lauyihong/lerobotneck/hardware/neck_v0_1/README.md

# neck_v0_1 CAD

| file | source | notes |
|---|---|---|
| `wallerobot_new_wrist_dof_0_1.stl` | user, 2026-11-04 | binary STL, mm, 66170 faces, one solid (+ a few degenerate slivers), exported in **part** coordinates (min corner at origin), not assembly coordinates |

## `wallerobot_new_wrist_dof_0_1.stl` — measured features (part frame, mm)

Extent 52.95 × 46.4 × 48.4. Two functional ends:

- **Socket** (X 0–15): rectangular pocket Y 11.4–36.4 × Z 11.4–46.3 (25.0 × 34.9), ~15 deep, open towards −X.
  The cross-section matches an STS3215 body (24.7 × 35). Ø5.0 through hole on the pocket floor along X at (Y 23.9, Z 28.0).
  Screw holes along Z, Y = 13.63 / 34.13 (20.5 apart): bottom wall at X 9.1 (Ø4 counterbore → Ø2 pilot),
  top wall at X 12.9 (Ø2 pilot → Ø4 counterbore).
- **Fork** (X ≈ 20–53): two arms, inner faces Y ≈ 3.5 and 42.9 (gap ≈ 39.4). Both arm ends carry a horn pattern on one
  axis: **rotation axis ∥ Y through (X 41.0, Z 12.0)**; Ø6.0 centre hole, 4 × Ø3.2 (Ø5.4 counterbore on the outer face)
  on a Ø14.1 bolt circle.

Socket axis (X, through Y 23.9 / Z 28.85) → fork axis: 16.85 mm lower in Z, 26 mm beyond the pocket floor (X 15 → 41).

## Role in the neck (user photo 2026-11-04 + inference — confirm before building the URDF)

- This part is the **new link between J3 and J4**, replacing the SO101 `Lower_Arm` (J3→J4 = 134.9 mm in upstream URDF).
  Fork = on the J3 horn (J3 axis ∥ part Y). Socket = holds the J4 motor body.
- STS3215 in the upstream meshes: 45.4 × 24.8 × 39.6 (shaft ∥ the 39.6 side, shaft 10.2 mm from one end). The pocket
  takes the 24.8 side along Y and the 35 side along Z, so **the J4 shaft is ∥ Z, i.e. perpendicular to J3**
  (in SO101 J3 ∥ J4). **Confirmed by user 2026-11-04: J4 swings the camera sideways.** The downstream SO101 wrist
  (J4→J6) is therefore rotated 90° about the link axis relative to stock SO101.
  If the non-shaft end sits on the pocket floor, the J4 axis passes through (X ≈ −20.2, Y 23.9),
  ≈ 61 mm from the J3 axis along X (position not yet measured on the real part).
- Camera end: D435i holder from upstream XLeRobot on the J6 horn. CAD available in
  `third_party/XLeRobot/hardware/step/RGBD_Gimbal/Gimbal_Pitch_Holder_d435_d415.step` and
  `third_party/XLeRobot/hardware/camera_connector/Gimbal_mesh_all_d435.stl`; upstream URDF puts `head_camera_link`
  at (0.025, 0, 0.03) m from the head tilt axis (rounded values).
- Rest of the chain (J1/J2 base + shoulder, upper arm, wrist, J6 housing) looks like stock SO101 in the photo.

## URDF draft v0.1 — `urdf/wallerobot_neck.urdf`

Generated by `build_urdf.py` (edit the script, then re-run; it also checks the file loads in MuJoCo).
Preview: `render_mj.py --q j1,..,j6 (deg) --out x.png` (MuJoCo, coloured) or `view_urdf.py` (matplotlib) — `guess_q0.png` (zero pose), `guess_j4_AB.png` (J4 horn question, answered B), `compare_photo_fold.png` (user photos vs URDF in an eyeballed folded pose).

```
wallerobot_body (root, upstream top_base_link) --fixed--> neck_base (SO101 Base frame) --neck_j1--> neck_shoulder --neck_j2--> neck_upper_arm --neck_j3--> neck_link34 (our STL)
  --neck_j4--> neck_wrist (SO101 Wrist_Pitch_Roll) --neck_j5--> neck_cam_tilt_housing (SO101 Fixed_Jaw, J6 motor)
  --neck_j6--> neck_cam_holder (XLeRobot head-tilt holder + D435i) -> neck_camera_link -> neck_camera_color_optical_frame
```

Joint names neck_j1..neck_j6 = motor IDs 7..12. Zeros (= what the calibration reference pose must reproduce):
J1, J2 as the SO101 URDF (J2 = 0: upper arm stretched out horizontally); J5 = 0: user's normal state, D435i landscape + upright below the J6 housing (SO101 zero − 90°); J3 = 0: J4 motor in line with the upper arm;
J4 = 0: wrist straight along the J4 motor; J6 = 0: camera optical axis along the J5 roll axis, looking away from the wrist.
At q = 0 the neck is stretched out horizontally and the camera looks straight forward (`preview_q0.png`).

| item | status |
|---|---|
| J1–J3, wrist J4→J6 frames | upstream SO101 (`third_party/XLeRobot/simulation/xlerobot/xlerobot.urdf`, left arm) |
| J3→J4 (new link) | from the STL: J3→J4 axis offset 61.2 mm along the link + 16.85 mm sideways |
| `LINK34_SIDE = -1` | inferred from the photo (J4 motor on the far side from the upper arm when folded; `preview_link_side_check.png`) |
| `J4_SHAFT_SIGN = -1` | user 2026-11-04: real neck stretched out looks like variant **B** in `guess_j4_AB.png` |
| `HOLDER_FLIP = -1` | user: holder is mirrored vs the old head ("pink is reversed"); photo only fits -1 (camera body below-forward of the J6 horn) |
| J4 motor insertion depth | **ASSUMPTION** — non-shaft end on the pocket floor; measure J3↔J4 axis distance with calipers to confirm |
| camera in holder | upstream head values (`head_camera_link` 25 mm fwd / 30 mm up of the tilt axis, rounded); colour vs depth optical offset not modelled yet (SDK extrinsics) |
| joint limits | from `neck_calibration.json` (calibrated 2026-11-05, see Calibration below) |
| J6 housing | user 2026-11-04: real part = XLeRobot TPU-finger fixed jaw with the finger removed -> `cam_tilt_housing_softfin.stl` (largest body of `third_party/XLeRobot/hardware/SO101_soft_fin.stl`), ICP-placed in the SO101 Fixed_Jaw frame (0.39 mm median) |
| neck base / mount | user 2026-11-04: SO101 Base replaced by the XLeRobot neck part. Root = `wallerobot_body` (= upstream `top_base_link`, topbase1/2 meshes); J1 motor ICP-matched onto the old head-pan motor (0.44 mm), J1 axis at x -104 mm (upstream pan axis -103). Robot forward = body -X (left arm at -Y shows on the image left). Real body vs upstream CAD not measured |
| J5 zero / camera upright | user 2026-11-04 picked **C** in `guess_j5_ABCD.png` as the normal state: `J5_ZERO_SHIFT = -90 deg` (vs SO101 zero), holder + camera below the J6 housing (matches the folded photo). User says the camera is upright there, so `CAM_FLIP`: D435i rotated 180 deg about its optical axis in the holder vs upstream (unverified with a live frame; colour lens lateral offset not modelled) |
| inertias | placeholders (0.05 kg links) so simulators accept the file |
| base visuals | user 2026-11-05 picked **candidate 4** in `guess_base_candidates.png` = upstream `hardware/step/Archiv/Neck.step`: truss tower + separate J1 housing ("Folder 136", 65×65×60 mm). Same frame as `Assembly_RGBD_Gimbal.step` (identical tower bounds) → body frame by a pure translation (0.65 mm ICP). `make_base_meshes.py` writes `base_body_lower.stl` (upstream topbase1 cut below the tower at z 106.5 mm), `base_tower.stl`, `base_j1_housing.stl`; topbase2 kept as the J1 motor. The housing encloses the J1 motor where it already was (J1 axis x −104 mm) → **J1 position and zero unchanged**, calibration still valid. Check: `compare_base4.png` (home pose vs photos), `guess_q0.png` |

## Calibration — `tools/calib_neck.py`

Hand-guided, torque never enabled. `guide` renders `calib_guide.png` (zero pose + the `+30°` direction of every joint),
`calibrate` records per joint: zero (homing so it reads 2047), sign (you turn it the way the guide shows), range
(unwrapped, so J5 may cross the encoder wrap; > 1 rev is clipped symmetrically) → EEPROM offset re-centred on the range
midpoint + limits minus a 40-tick margin, and `neck_calibration.json` (`q = sign·(Present_Position − zero_tick)·2π/4096`).
Old EEPROM values are backed up to `calib_backups/` and restored on any failure or Ctrl+C. `build_urdf.py` takes the
joint limits from `neck_calibration.json` when it exists. `show` reads the encoders and renders `live_pose.png`.
Tested offline against a simulated bus (wrap, reversed signs, J5 > 1 rev, bad reads).
The input-voltage status error on IDs 9/10/11 that blocked LeRobot was cleared 2026-11-04 (Max_Voltage_Limit 12.0 → 14.0 V,
see `hardware.yaml` → `eeprom_20261104_evening.fix_20261104`).

**Calibrated on the robot 2026-11-05 00:4x** (3rd attempt; backup `calib_backups/eeprom_20261105-000939.json`), read-back ±1 tick:

| joint | ID | homing | range (ticks) | zero tick | sign | URDF limits (°) |
|---|---|---|---|---|---|---|
| neck_j1 | 7 | −1861 | 910..3185 | 1920 | +1 | −89 .. +111 |
| neck_j2 | 8 | −1224 | 895..3200 | ~~2942~~ **3022** (IMU demo fit) | −1 | −16 .. +187 |
| neck_j3 | 9 | +1505 | 1095..3000 | ~~1108~~ **948** (fixed, see below) | +1 | ~~−1 .. +166~~ **+13 .. +180** |
| neck_j4 | 10 | +1545 | 863..3232 | ~~2076~~ **2037** (IMU fit) | −1 | −105 .. +103 |
| neck_j5 | 11 | +118 | 182..3913 | 992 | −1 | −257 .. +71 |
| neck_j6 | 12 | −838 | 1203..2891 | 2120 → 2219 → **2115** (IMU demo fit) | +1 | −80 .. +68 |

URDF rebuilt with these limits. Notes: the drooping rest pose puts J2 at −26° = 41 ticks past range_max (the 40-tick margin)
→ with torque on, the motor would clamp the goal to the limit (≈4° move). J1 sign differed between the aborted 1st run (−)
and runs 2/3 (+). **User 2026-11-05: `live_pose.png` (q = −5, −26, +45, −0, −5, +23°) matches the real neck** → signs
and zeros accepted.

**Poses** (`tools/calib_neck.py save-pose <name>`, stored under `poses` in `neck_calibration.json`):
`home` (2026-11-05, user: use as init / return position) = folded rest, camera forward,
q = −5.3, +187.2, +185.0 (was +171.0 before the J3 zero fix), +1.2 (was +4.7), −1.2, −1.1 (was +7.6, IMU fit)°. J2/J3 rest on the mechanical stop beyond
the calibrated limits → use `target_ticks` / `target_q_deg` (J2 +179.9°, J3 +180.3°, clamped to the limits) as the goal,
never push further into the stop.

**J3 zero fix (2026-11-05)**: in the folded home pose the real wrist touches the upper arm, but with zero_tick 1108 the model
(J3 +171°) showed a 13.8 mm gap. User: the real neck looks like the model at ~+184.5° → the eyeballed J3 zero ("J4 motor in
line with the upper arm") was ~13° off; fix it from the contact. Model contact (signed-distance sweep, wrist vs upper arm at the
home pose) = J3 **+185.1°**; real fold stop = tick **3054** (`watch_neck_j3.json` max, home 3053–3055) → `zero_tick` 1108 → **948**
(file only, EEPROM untouched; backup `calib_backups/neck_calibration_20261105-before_j3_zero_fix.json`). Home now reads J3 +185.0°,
model gap ≈ 0 (`compare_elbow_home.png`). Open point: J3 stretched to its stop by hand read −4.3° old = **+9.8° new**, while the
model's extension contact is ≈ −5..−8° → the real extension stop is something not in the model (not pushed hard; cable / horn?)
— harmless, the URDF lower limit is +13°.
| neck_base → robot body / arm bases | from upstream CAD (see neck base row); upstream arm bases Base/Base_2 at (-0.09, ∓0.11, 0.395) in chassis = (-0.09, ∓0.11, 0.045) in top_base_link |

**Archive**: `archive/neck_v0_1_20261105.zip` (+ `MANIFEST_20261105.md`) = snapshot of this folder after the J3 zero fix (URDF + meshes, calibration, backups, photos, scripts). Helpers: `check_fold_contact.py` (J3 fold contact sweep), `compare_elbow.py` (photo vs model elbow).

**IMU zero fix J4/J6 (2026-11-05)**: D435i gravity vs the twin (`projects/sim_mirror/scripts/imu_fit.py`) over 3 static poses
(2 hand-posed + the home `imu_check`) said the camera pitch was 8.7° off. With J2 held at its rest-stop anchor and the camera roll in
the holder fixed at 0 (fit: +0.7 ± 0.5°, not significant): **J6 −8.68 ± 0.45°** → `zero_tick` 2120 → **2219**, **J4 −3.43 ± 0.57°** →
2076 → **2037** (file only, EEPROM untouched; backup `calib_backups/neck_calibration_20261105-before_imu_fix.json`). rms 9.1° → 0.9°;
an independent 4th pose (J4 +18, J6 −52, roll −21°) afterwards: 0.9° between real and sim gravity. **Provisional**: J4/J5 were small in
every pose, so the J2 and J6 axes were parallel and only δJ2 − δJ6 is measured (4-pose fit with J2 free: δJ2 +0.5 ± 12°). Orientation
is right either way; a J2/J6 split error would move the camera *position* by up to a few cm → resolve with poses where J4/J5 are
swung ±40° or with an AprilTag.

**IMU demo fit (2026-11-06, supersedes the J6 part above)**: 11 torque-held poses from the neck demo
(`projects/torque_bringup`; J4 swung ±40°, J5 −60..+45°, so the J2 and J6 axes are no longer parallel) separate J2 from J6:
**J2 +7.07 ± 0.66°** → `zero_tick` 2942 → **3022**; **J6 +9.18 ± 0.70°** → 2219 → **2115**, back to about the original 2120.
J4, J5 and the camera roll fitted < 1° (not significant): J4 stays at 2037 (−3.4° from the 2026-11-05 fit; within ~2σ of
this fit's +0.5 ± 0.9). rms 3.6° → 1.1°; the 4 independent older samples give 2.0° with the new values. The home pose now reads
J2 **+194.2°** (target +186.9° = the limit). J2 carries the J3 sum (parallel axes; J3 is pinned by the fold contact).
File only; backup `calib_backups/neck_calibration_20261106-before_demo_imu_fix.json`.
**neck_j6 with torque**: it drives to a wrong target (a constant-acceleration move into its stop, not a broken loop; cause
open, see `projects/torque_bringup/README.md`). Keep it limp until solved.
