lauyihong/lerobotneck/hardware/wallerobot_v0_1/JOINTS.md

# wallerobot v0.1 — joints

<!-- generated by hardware/wallerobot_v0_1/joint_table.py — do not edit by hand -->
| joint | bus / ID | sign | zero tick | EEPROM range | URDF limit (deg) | rest / home (deg) | notes |
|---|---|---|---|---|---|---|---|
| `left_arm_shoulder_pan` | COM3 / 1 | +1 | 2028 | 809..2559 | -107.1 .. +46.7 | +0.0 |  |
| `left_arm_shoulder_lift` | COM3 / 2 | −1 | 4174 | 0..4095 | -12.6 .. +193.1 | +187.0 | rests on the fold stop; no EEPROM limit (0..4095); encoder wrap 180° from rest lies in the travel → torque refused until Homing_Offset is re-centred |
| `left_arm_elbow_flex` | COM3 / 3 | +1 | 6 | 0..4095 | -12.6 .. +179.9 | +180.0 | same as shoulder_lift |
| `left_arm_wrist_flex` | COM3 / 4 | +1 | 1125 | 166..2315 | -84.3 .. +95.0 | +50.0 |  |
| `left_arm_wrist_roll` | COM3 / 5 | +1 | 924 | 7..4087 | -80.6 .. +162.8 | +90.0 |  |
| `left_arm_gripper` | COM3 / 6 | lin | closed 1997 / open 3495 | 1981..3495 | -22.0 .. +100.0 | -22.0 | parallel gripper (model: stock SO101 jaw); linear closed..open |
| `neck_j1` | COM3 / 7 | +1 | 1920 | 910..3185 | -88.8 .. +111.2 | +6.8 | base pan |
| `neck_j2` | COM3 / 8 | −1 | 3022 | 895..3200 | -15.6 .. +186.9 | +190.2 | neck lift, rests on its fold stop past the limit (home target = limit); zero from the IMU demo fit |
| `neck_j3` | COM3 / 9 | +1 | 852 | 1186..2908 | +29.4 .. +180.7 | +185.1 | elbow, rests past the limit; zero from the wrist/upper-arm fold contact |
| `neck_j4` | COM3 / 10 | −1 | 2042 | 906..3187 | -100.6 .. +99.8 | +0.2 | side swing, axis ⟂ J3 (new link STL) |
| `neck_j5` | COM3 / 11 | −1 | 992 | 182..3913 | -256.7 .. +71.2 | +1.6 | camera roll; Phase 92 batch (ids 9-11) |
| `neck_j6` | COM3 / 12 | +1 | 2115 | 1203..2891 | -80.2 .. +68.2 | +10.7 | camera tilt; drives to a wrong target with torque on → keep limp (cause open) |
| `right_arm_shoulder_pan` | COM4 / 1 | +1 | 2045 | 1457..3198 | -51.7 .. +101.3 | +0.0 |  |
| `right_arm_shoulder_lift` | COM4 / 2 | −1 | 4187 | 0..4095 | -12.6 .. +193.1 | +187.0 | rests on the fold stop; no EEPROM limit (0..4095); encoder wrap 180° from rest lies in the travel → torque refused until Homing_Offset is re-centred |
| `right_arm_elbow_flex` | COM4 / 3 | +1 | 1 | 0..4095 | -12.6 .. +179.9 | +180.0 | same as shoulder_lift |
| `right_arm_wrist_flex` | COM4 / 4 | +1 | 1237 | 351..2051 | -77.9 .. +71.5 | +50.0 |  |
| `right_arm_wrist_roll` | COM4 / 5 | +1 | 2177 | 126..3792 | -157.2 .. +141.9 | +90.0 |  |
| `right_arm_gripper` | COM4 / 6 | lin | closed 2022 / open 3529 | 1991..3529 | -22.0 .. +100.0 | -22.0 | parallel gripper (model: stock SO101 jaw); linear closed..open |

Angle convention: `q = sign · (Present_Position − zero_tick) · 360/4096` (Present_Position includes the EEPROM Homing_Offset); grippers are linear from closed_tick..open_tick to closed..open rad. Rest/home = arms' standard rest pose (`arm_calibration.json` rest_pose) and the neck `poses.home` (`neck_calibration.json`).
