lauyihong/lerobotneck/docs_site/_static/img/lerobotneck_ready.png

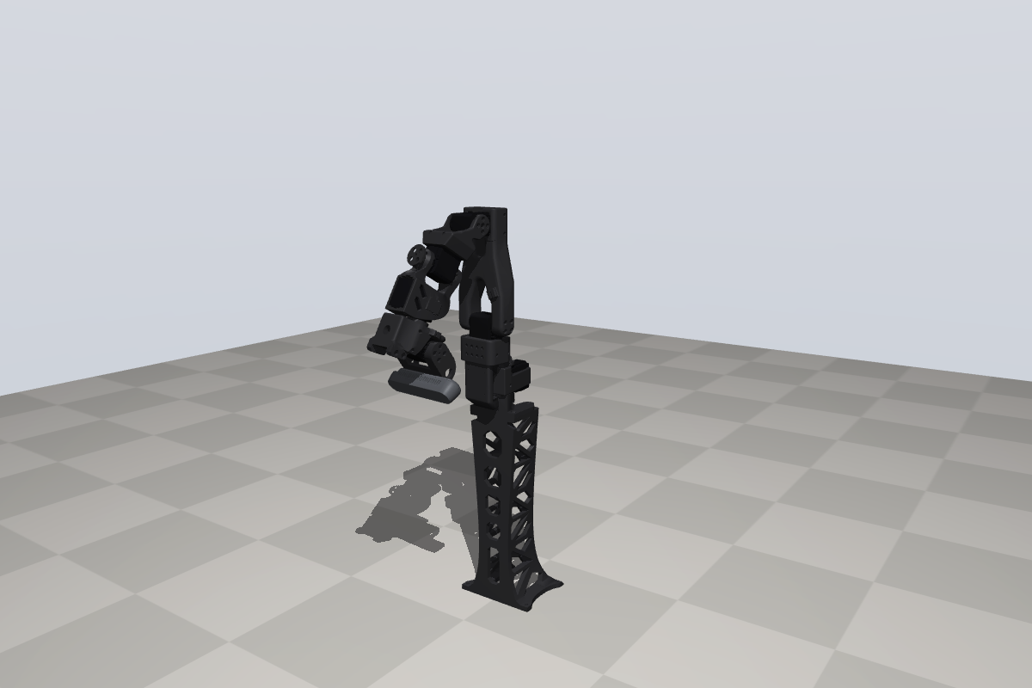
docs_site/_static/img/lerobotneck_ready.png
