lauyihong/lerobotneck/hardware/neck_v0_1/preview_pose.png

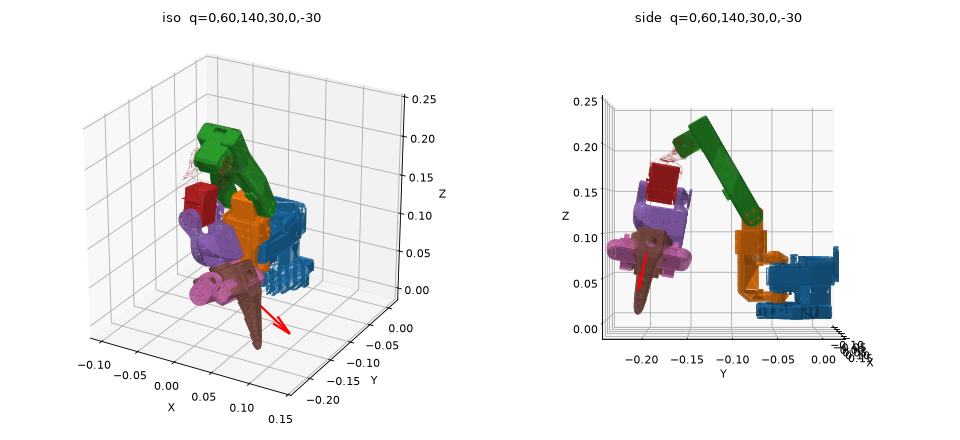
hardware/neck_v0_1/preview_pose.png
