lauyihong/lerobotneck/hardware/neck_v0_1/preview_q0.png

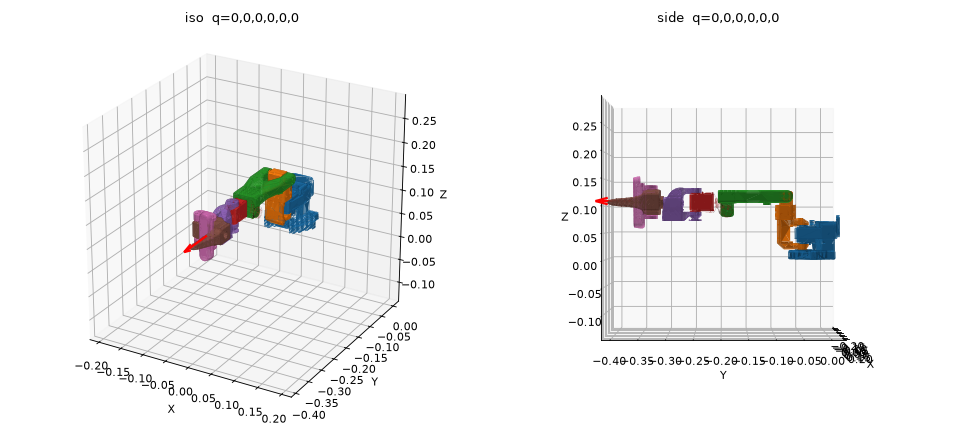
hardware/neck_v0_1/preview_q0.png
