lauyihong/lerobotneck/hardware/wallerobot_v0_1/preview_q0.png

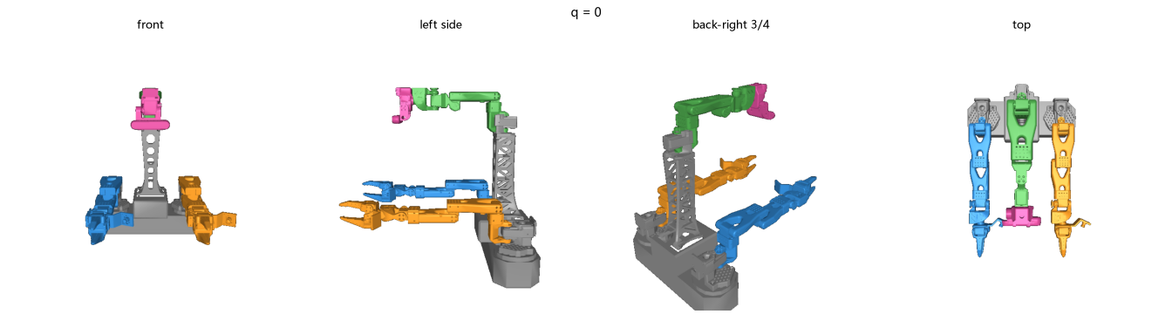
hardware/wallerobot_v0_1/preview_q0.png
