lauyihong/lerobotneck/hardware/wallerobot_v0_1/preview_rest.png

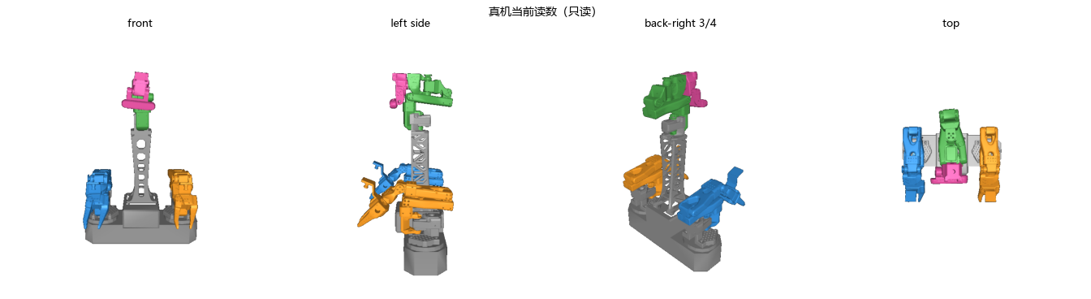
hardware/wallerobot_v0_1/preview_rest.png
