lauyihong/lerobotneck/hardware/neck_v0_1/base_body_lower.stl

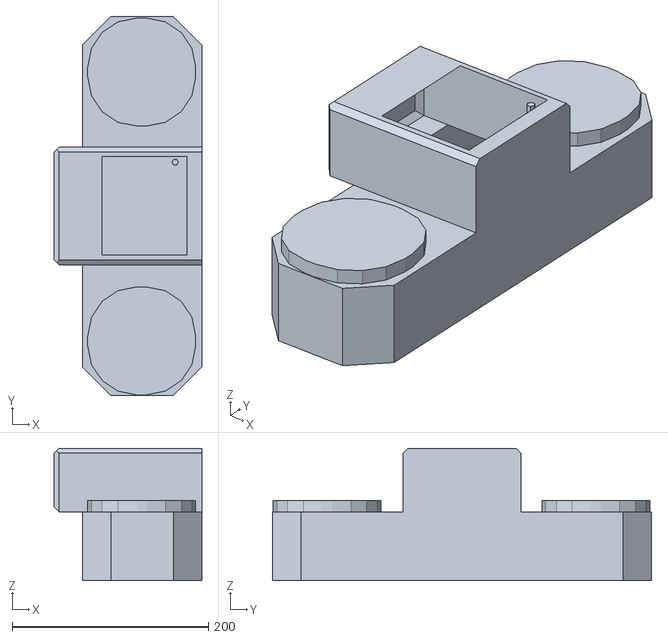
[picture p12: CAD file, 2026-11-08]
hardware/neck_v0_1/base_body_lower.stl
150.4 x 386.3 x 135.0
