lauyihong/lerobotneck/hardware/neck_v0_1/urdf/meshes/Base.stl

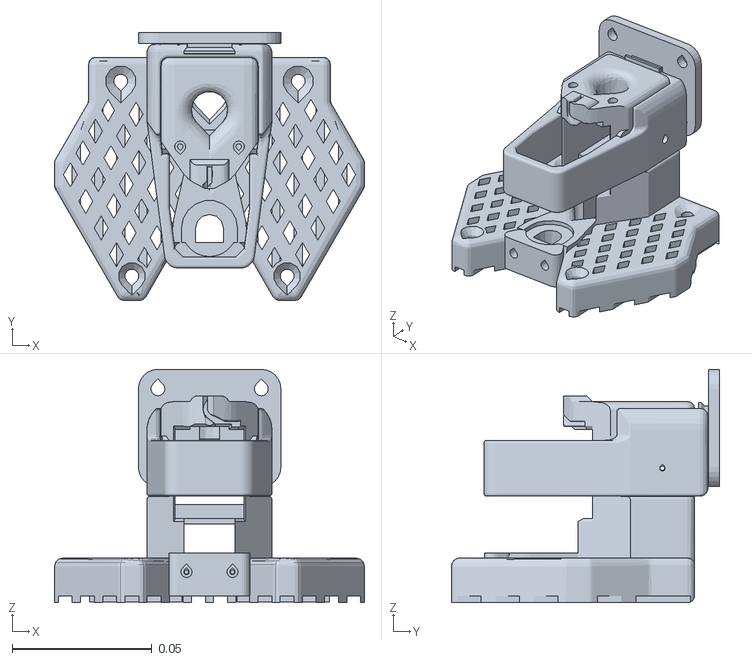
[picture p13: CAD file, 2026-11-08]
hardware/neck_v0_1/urdf/meshes/Base.stl
0.111 x 0.0959 x 0.0835
