lauyihong/lerobotneck/hardware/upstream/xlerobot/meshes/tophead4.stl

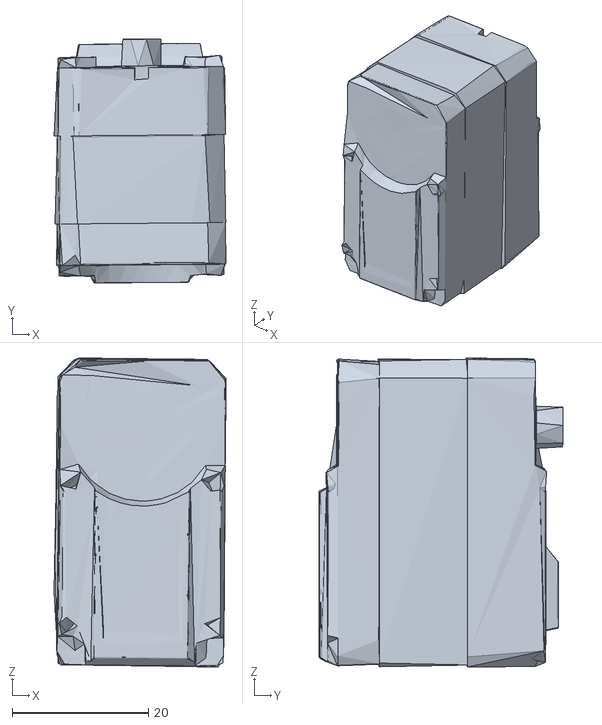
[picture p14: CAD file, 2026-11-10]
hardware/upstream/xlerobot/meshes/tophead4.stl
25.2 x 35.8 x 45.3
