lauyihong/lerobotneck/hardware/wallerobot_v0_1/urdf/meshes/Lower_Arm.hull.stl

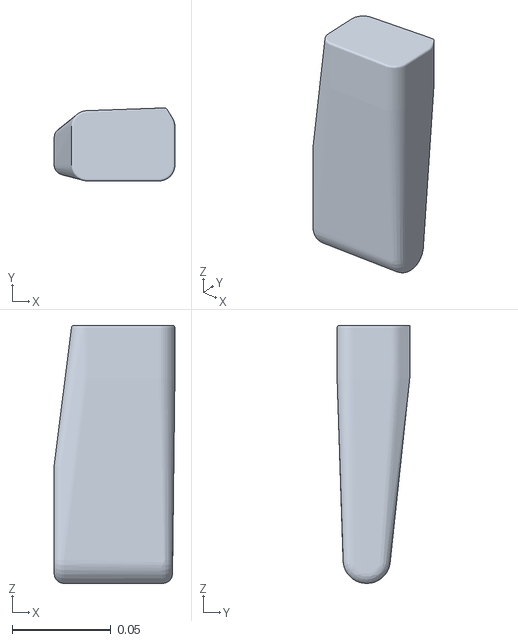
[picture p15: CAD file, 2026-11-08]
hardware/wallerobot_v0_1/urdf/meshes/Lower_Arm.hull.stl
0.0612 x 0.0369 x 0.131
