lauyihong/lerobotneck/projects/web_sim/web/public/model/meshes/Lower_Arm_Motor.hull.stl

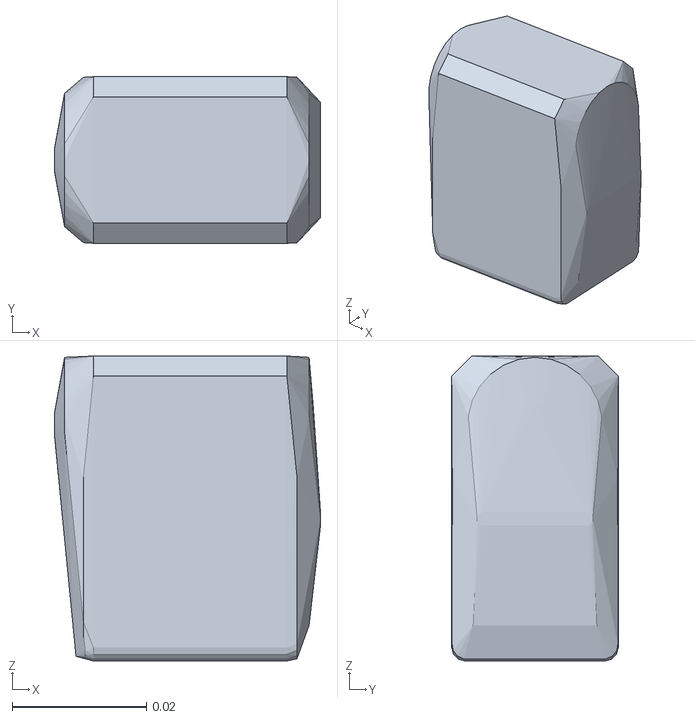
[picture p16: CAD file, 2026-11-08]
projects/web_sim/web/public/model/meshes/Lower_Arm_Motor.hull.stl
0.0396 x 0.0248 x 0.0454
