lauyihong/lerobotneck/projects/web_sim/web/public/model_neck/meshes/Upper_Arm_Motor.stl

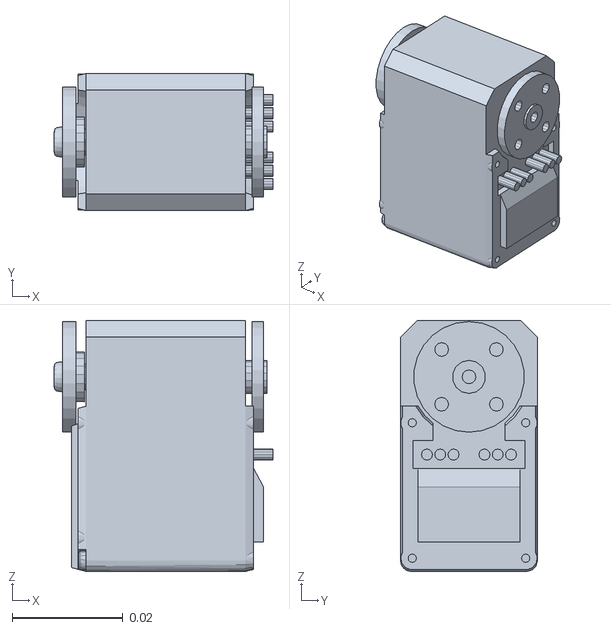
[picture p17: CAD file, 2026-11-08]
projects/web_sim/web/public/model_neck/meshes/Upper_Arm_Motor.stl
0.0396 x 0.0248 x 0.0454
