lauyihong/lerobotneck/hardware/neck_v0_1/urdf/meshes/topbase1.stl

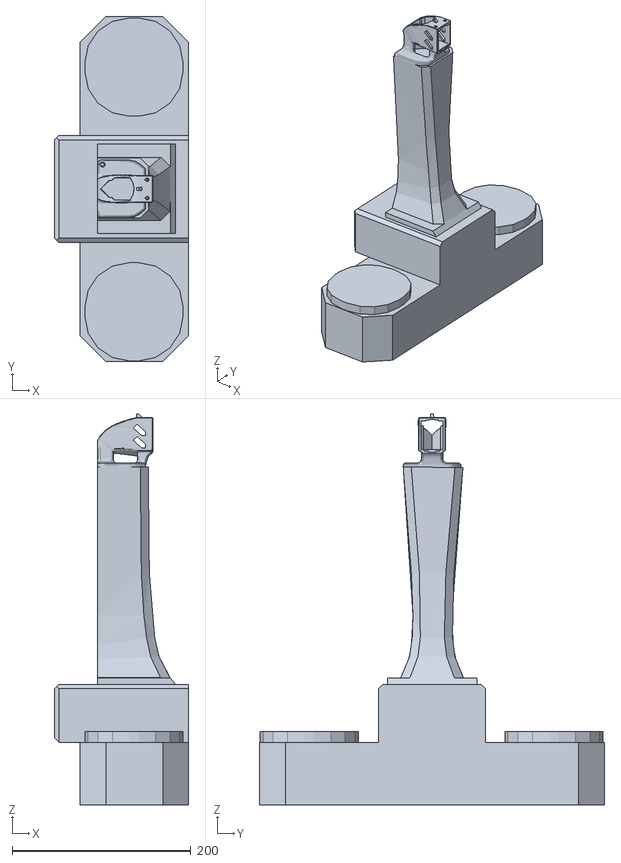
[picture p18: CAD file, 2026-11-08]
hardware/neck_v0_1/urdf/meshes/topbase1.stl
150.4 x 386.3 x 437.4
