lauyihong/lerobotneck/hardware/upstream/xlerobot/meshes/XLeRobot_camera1.stl

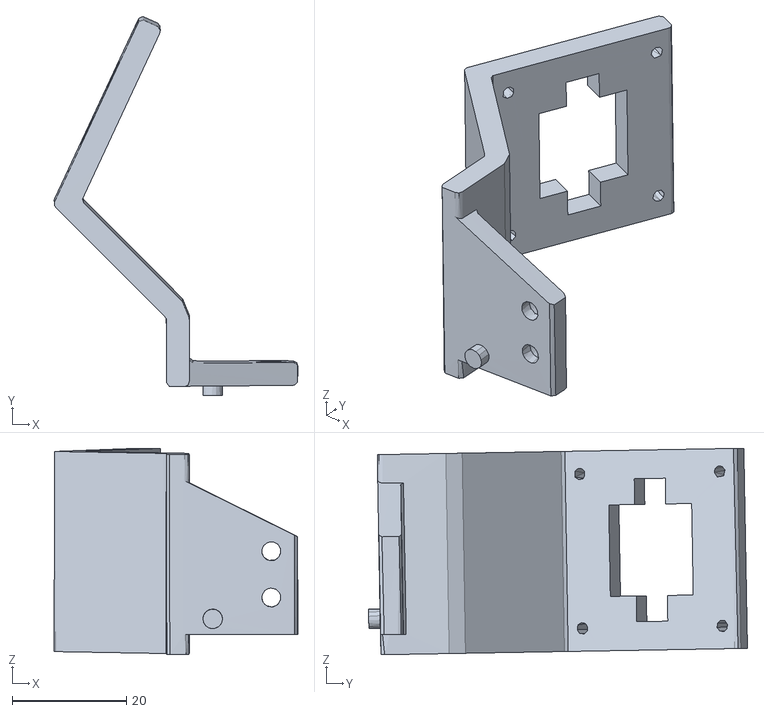
[picture p19: CAD file, 2026-11-08]
hardware/upstream/xlerobot/meshes/XLeRobot_camera1.stl
42.6 x 66.3 x 36.1
