lauyihong/lerobotneck/projects/web_sim/web/public/model/meshes/Wrist_Pitch_Roll_Motor.hull.stl

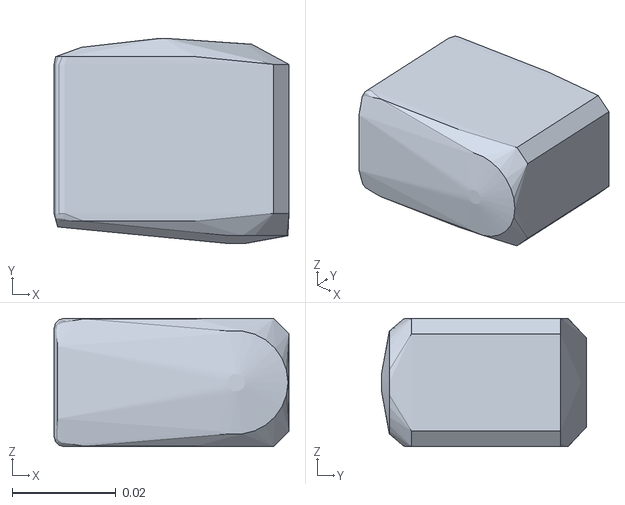
[picture p20: CAD file, 2026-11-08]
projects/web_sim/web/public/model/meshes/Wrist_Pitch_Roll_Motor.hull.stl
0.0454 x 0.0396 x 0.0248
