lauyihong/lerobotneck/projects/web_sim/web/public/model_neck/meshes/Upper_Arm.stl

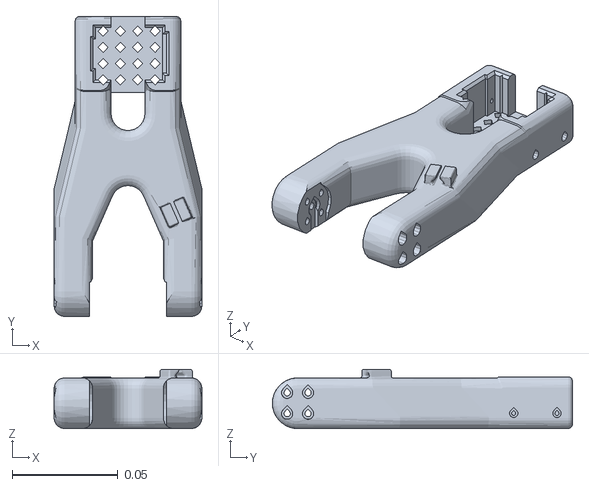
[picture p21: CAD file, 2026-11-08]
projects/web_sim/web/public/model_neck/meshes/Upper_Arm.stl
0.07 x 0.142 x 0.028
