lauyihong/lerobotneck/projects/web_sim/web/public/why/tophead6.stl

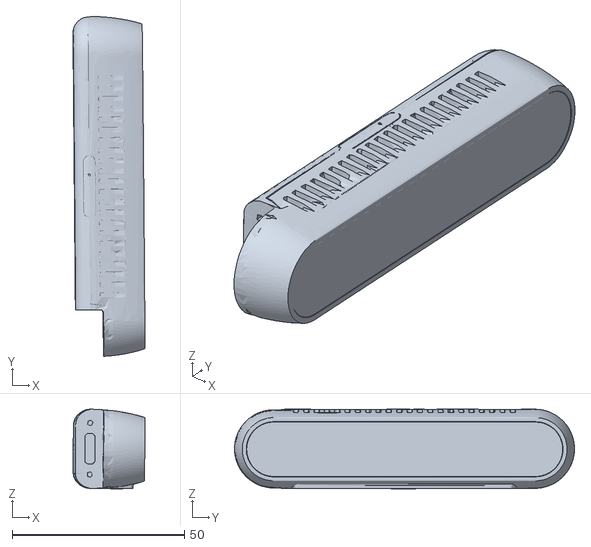
[picture p22: CAD file, 2026-11-08]
projects/web_sim/web/public/why/tophead6.stl
20.9 x 98.8 x 23.1
