lauyihong/lerobotneck/hardware/upstream/xlerobot/meshes/XLeRobot_camera2.stl

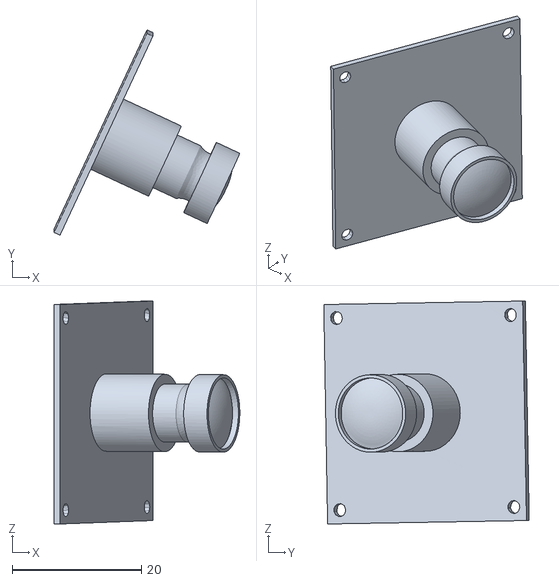
[picture p23: CAD file, 2026-11-08]
hardware/upstream/xlerobot/meshes/XLeRobot_camera2.stl
28.8 x 31.8 x 34.5
