lauyihong/lerobotneck/projects/web_sim/web/public/model/meshes/base_tower.hull.stl

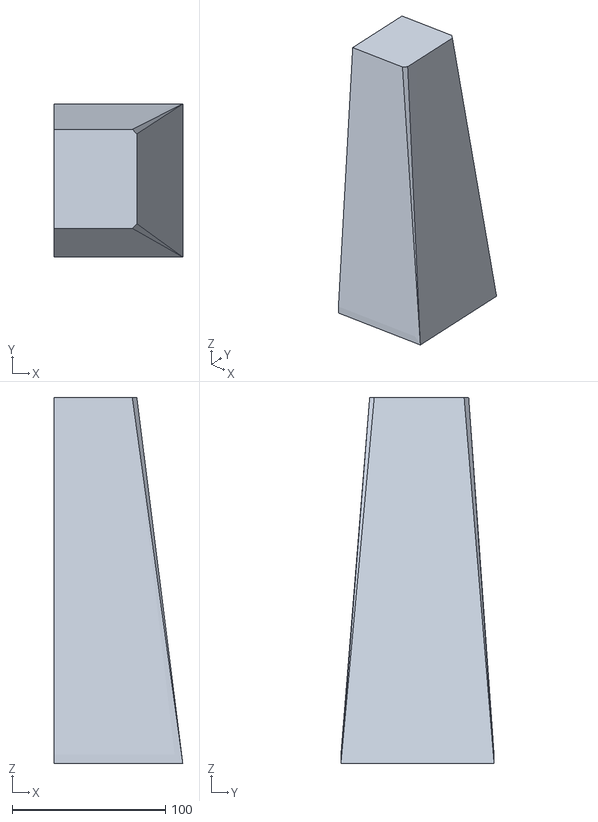
[picture p24: CAD file, 2026-11-08]
projects/web_sim/web/public/model/meshes/base_tower.hull.stl
84.0 x 100.0 x 239.0
