lauyihong/lerobotneck/projects/web_sim/web/public/why/tophead5.stl

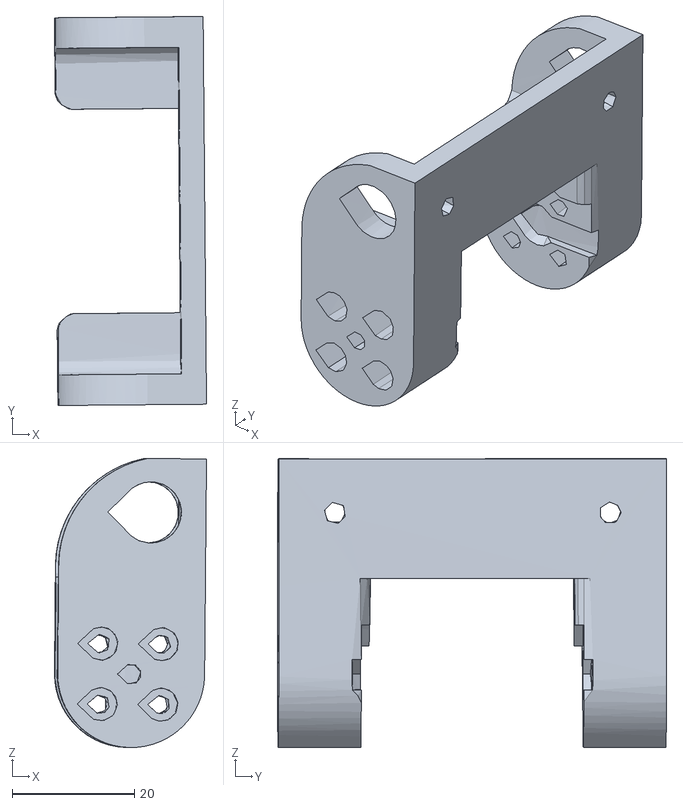
[picture p25: CAD file, 2026-11-08]
projects/web_sim/web/public/why/tophead5.stl
24.9 x 63.6 x 47.3
