lauyihong/lerobotneck/hardware/upstream/xlerobot/meshes/Fixed_Jaw_part2.ply.convex.stl

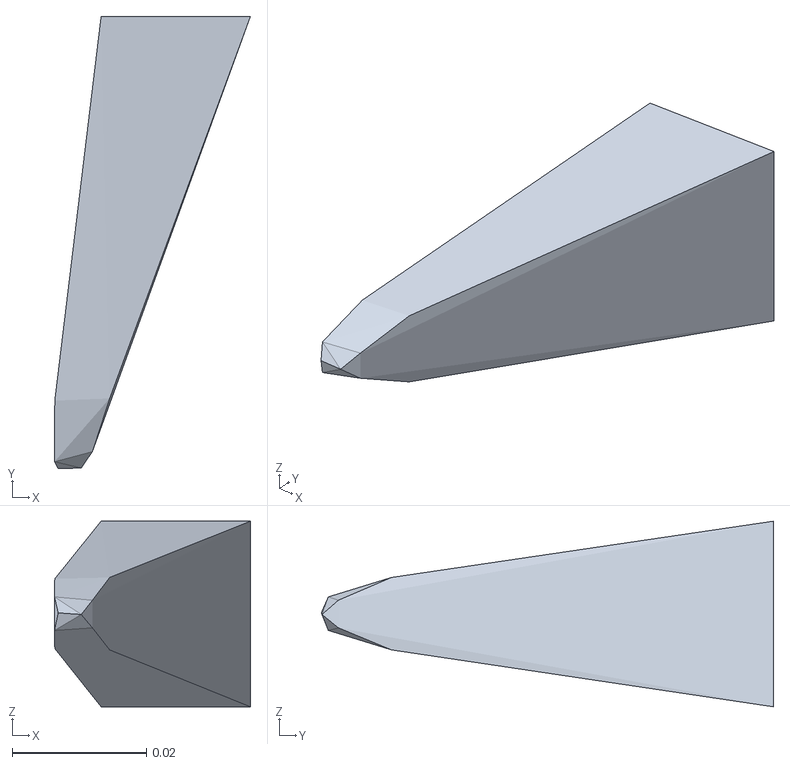
[picture p26: CAD file, 2026-11-08]
hardware/upstream/xlerobot/meshes/Fixed_Jaw_part2.ply.convex.stl
0.0292 x 0.0675 x 0.0277
