lauyihong/lerobotneck/projects/web_sim/web/public/model_neck/meshes/Wrist_Pitch_Roll.stl

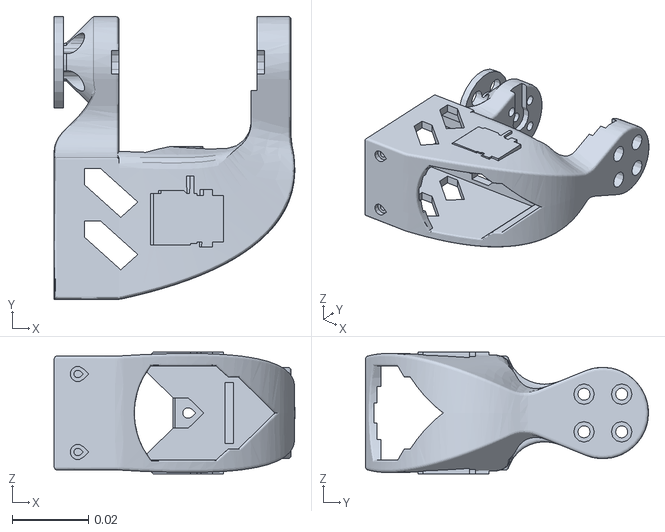
[picture p27: CAD file, 2026-11-08]
projects/web_sim/web/public/model_neck/meshes/Wrist_Pitch_Roll.stl
0.0633 x 0.0744 x 0.032
