lauyihong/lerobotneck/hardware/upstream/xlerobot/meshes/Moving_Jaw_part2.ply.convex.stl

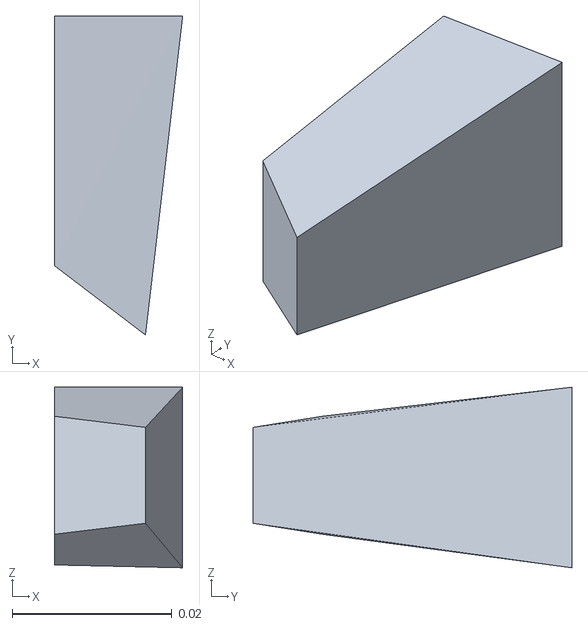
[picture p28: CAD file, 2026-11-08]
hardware/upstream/xlerobot/meshes/Moving_Jaw_part2.ply.convex.stl
0.0161 x 0.0399 x 0.0226
