lauyihong/lerobotneck/hardware/wallerobot_v0_1/urdf/meshes/Moving_Jaw_part1.ply.convex.stl

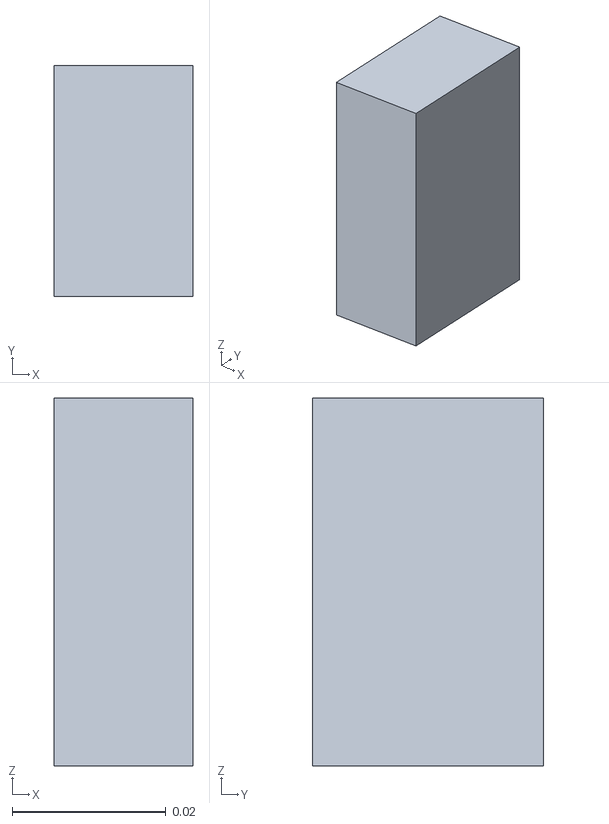
[picture p29: CAD file, 2026-11-08]
hardware/wallerobot_v0_1/urdf/meshes/Moving_Jaw_part1.ply.convex.stl
0.018 x 0.03 x 0.0478
