lauyihong/lerobotneck/hardware/wallerobot_v0_1/urdf/meshes/wallerobot_new_wrist_dof_0_1.hull.stl

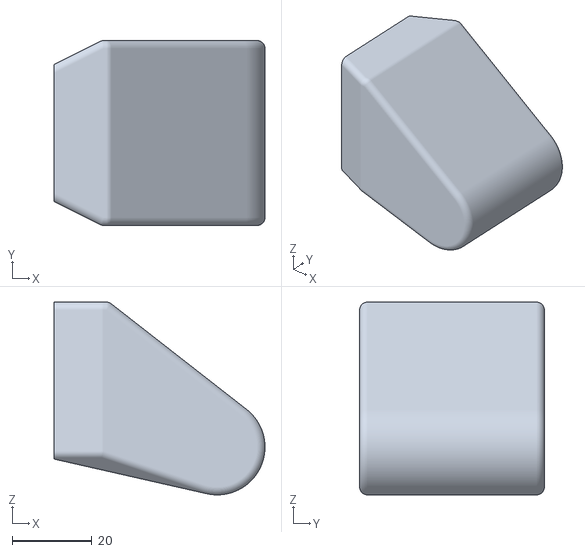
[picture p30: CAD file, 2026-11-08]
hardware/wallerobot_v0_1/urdf/meshes/wallerobot_new_wrist_dof_0_1.hull.stl
52.9 x 46.4 x 48.4
