lauyihong/lerobotneck/projects/web_sim/web/public/model_neck/meshes/base_tower.stl

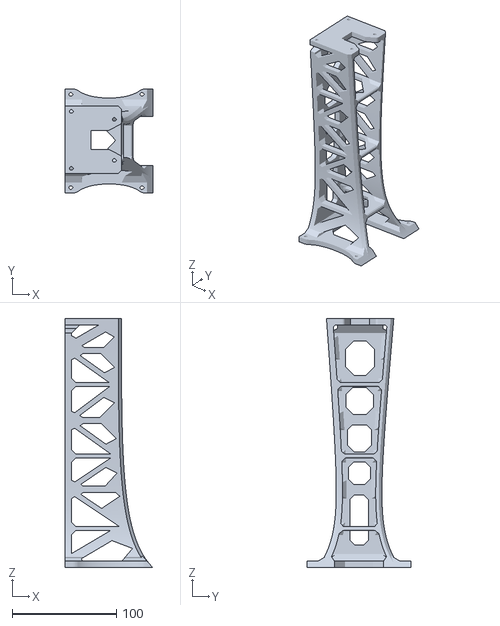
[picture p31: CAD file, 2026-11-08]
projects/web_sim/web/public/model_neck/meshes/base_tower.stl
84.0 x 100.0 x 239.0
