lauyihong/lerobotneck/hardware/wallerobot_v0_1/urdf/meshes/cam_tilt_housing_softfin.hull.stl

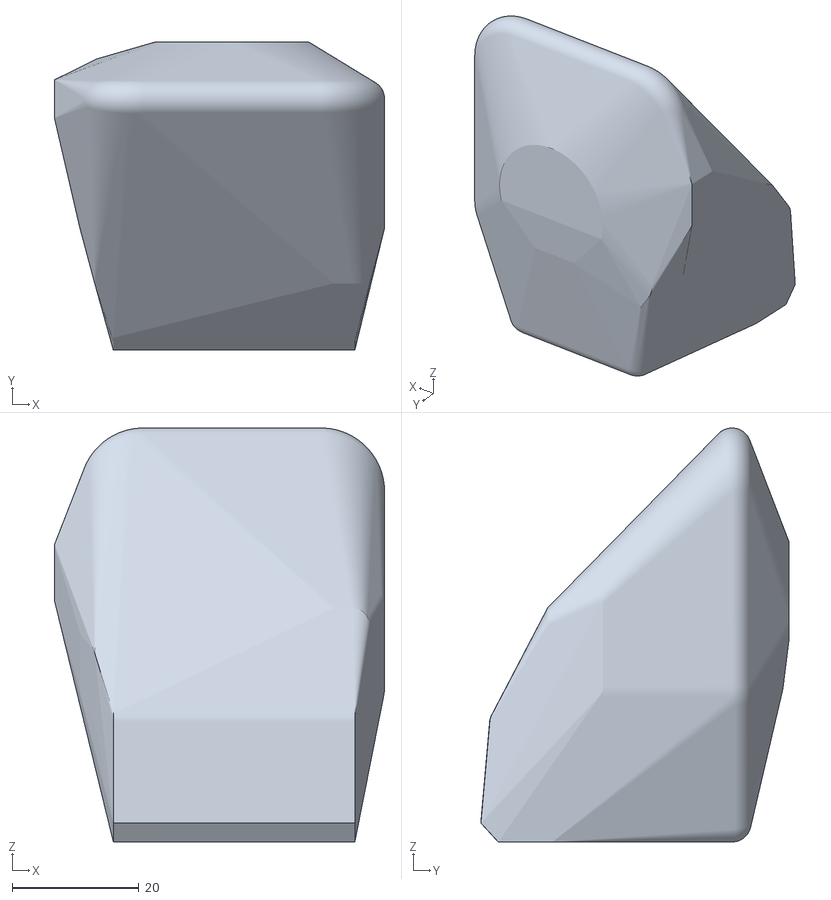
[picture p32: CAD file, 2026-11-08]
hardware/wallerobot_v0_1/urdf/meshes/cam_tilt_housing_softfin.hull.stl
52.0 x 48.6 x 65.2
