lauyihong/lerobotneck/projects/web_sim/web/public/model_neck/meshes/Rotation_Pitch.stl

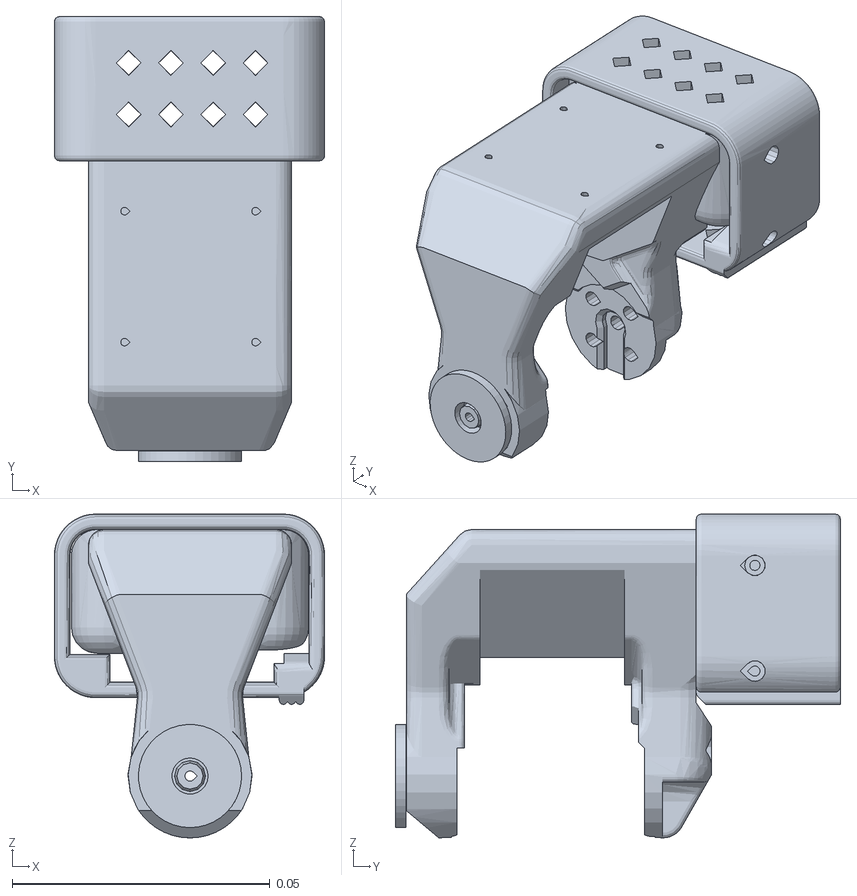
[picture p33: CAD file, 2026-11-08]
projects/web_sim/web/public/model_neck/meshes/Rotation_Pitch.stl
0.0524 x 0.0863 x 0.0628
