lauyihong/lerobotneck/hardware/upstream/xlerobot/meshes/Moving_Jaw_part3.ply.convex.stl

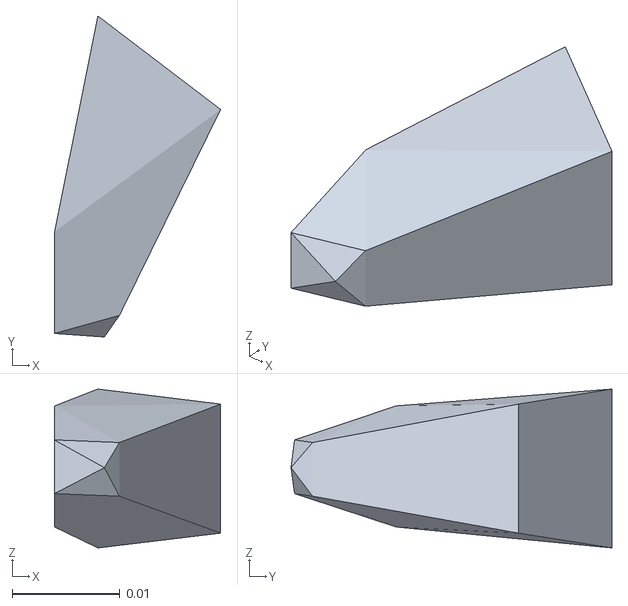
[picture p34: CAD file, 2026-11-08]
hardware/upstream/xlerobot/meshes/Moving_Jaw_part3.ply.convex.stl
0.0155 x 0.0298 x 0.0148
