lauyihong/lerobotneck/projects/web_sim/web/public/model/meshes/Base.hull.stl

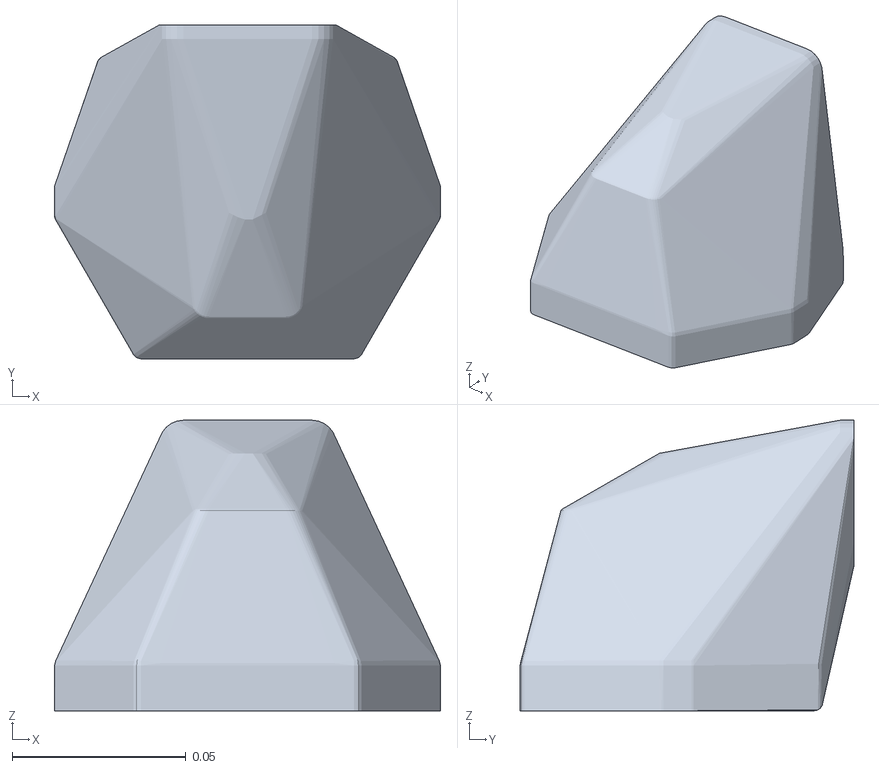
[picture p35: CAD file, 2026-11-08]
projects/web_sim/web/public/model/meshes/Base.hull.stl
0.111 x 0.0959 x 0.0835
