lauyihong/lerobotneck/projects/web_sim/web/public/model_neck/meshes/Wrist_Pitch_Roll_Motor.stl

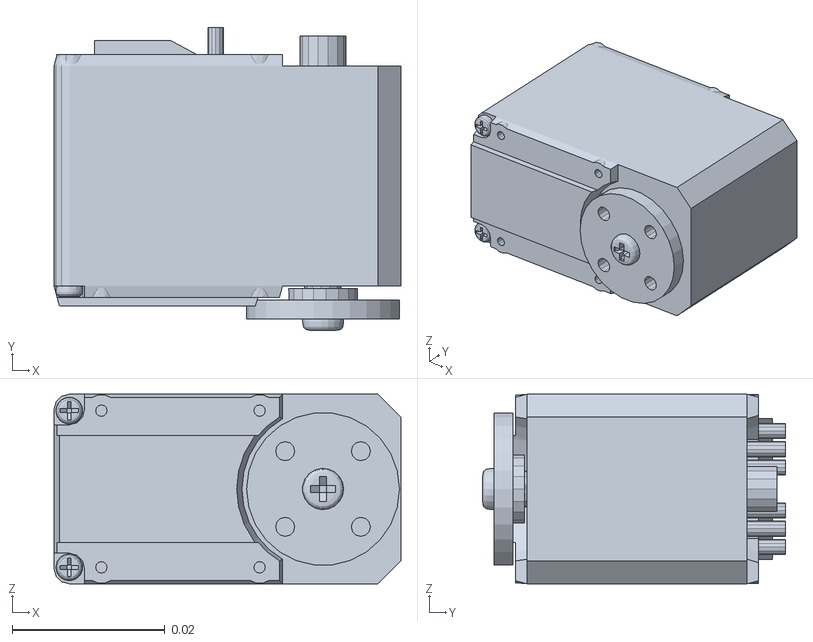
[picture p36: CAD file, 2026-11-08]
projects/web_sim/web/public/model_neck/meshes/Wrist_Pitch_Roll_Motor.stl
0.0454 x 0.0396 x 0.0248
