lauyihong/lerobotneck/projects/web_sim/web/public/model_neck/meshes/wallerobot_new_wrist_dof_0_1.stl

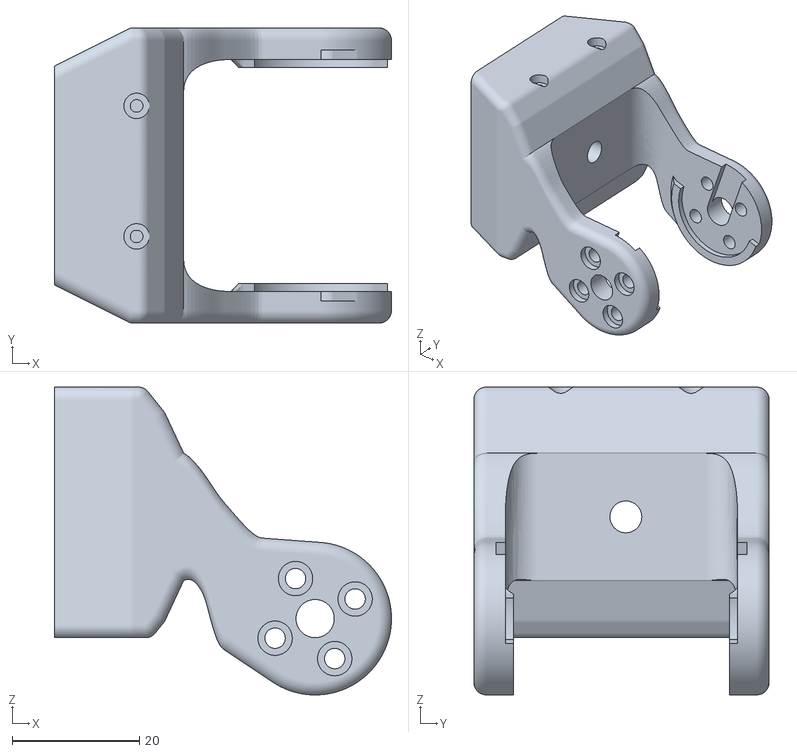
[picture p37: CAD file, 2026-11-08]
projects/web_sim/web/public/model_neck/meshes/wallerobot_new_wrist_dof_0_1.stl
52.9 x 46.4 x 48.4
