lauyihong/lerobotneck/hardware/upstream/xlerobot/meshes/Fixed_Jaw_part1.ply.convex.stl

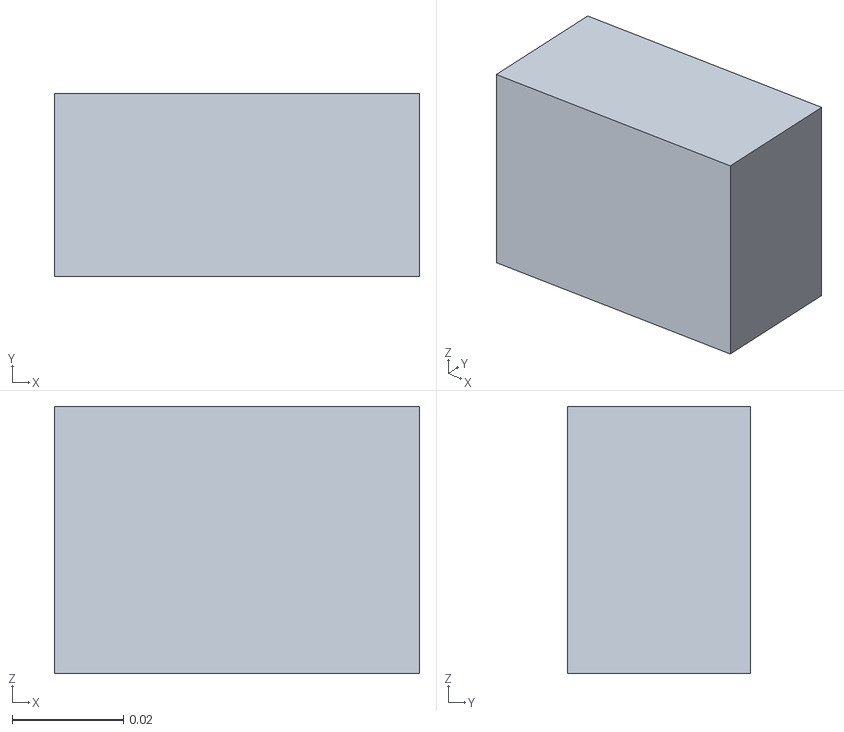
[picture p38: CAD file, 2026-11-08]
hardware/upstream/xlerobot/meshes/Fixed_Jaw_part1.ply.convex.stl
0.0656 x 0.0328 x 0.048
