lauyihong/lerobotneck/projects/web_sim/web/public/model_neck/meshes/cam_tilt_housing_softfin.stl

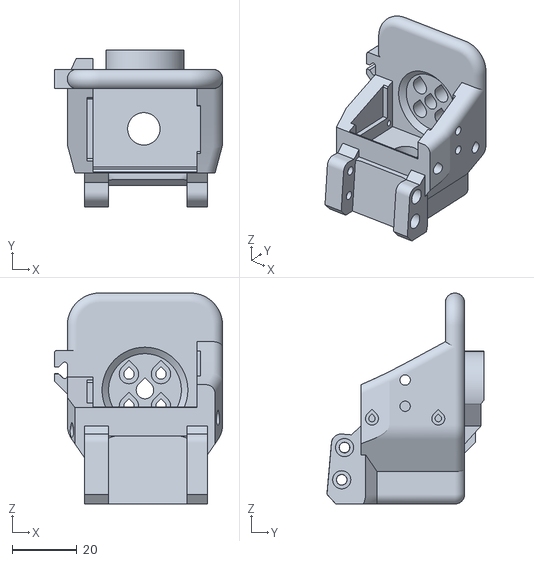
[picture p39: CAD file, 2026-11-08]
projects/web_sim/web/public/model_neck/meshes/cam_tilt_housing_softfin.stl
52.0 x 48.6 x 65.2
