lauyihong/lerobotneck/hardware/wallerobot_v0_1/urdf/meshes/Upper_Arm.hull.stl

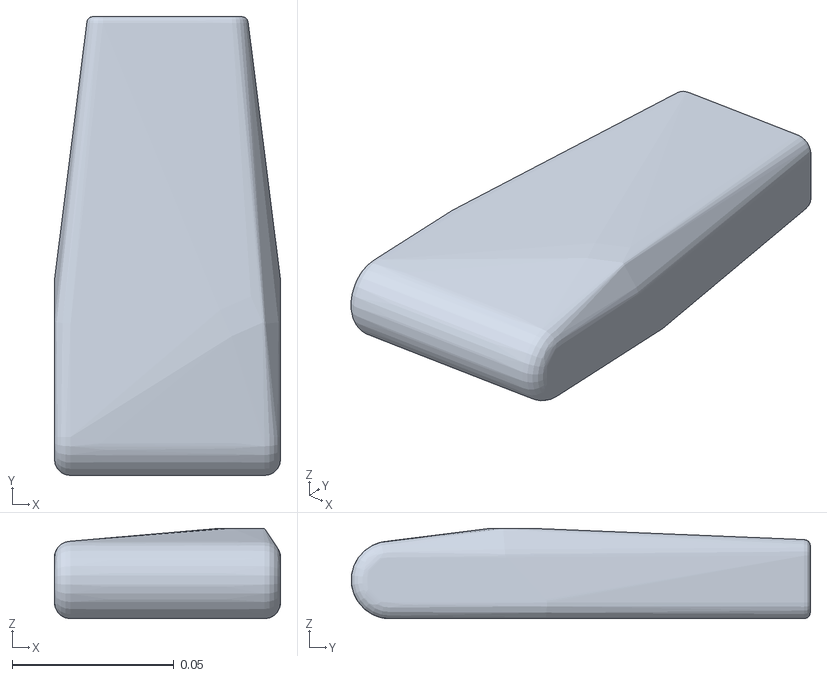
[picture p40: CAD file, 2026-11-08]
hardware/wallerobot_v0_1/urdf/meshes/Upper_Arm.hull.stl
0.07 x 0.142 x 0.028
