lauyihong/lerobotneck/projects/web_sim/web/public/model_neck/meshes/Fixed_Jaw.stl

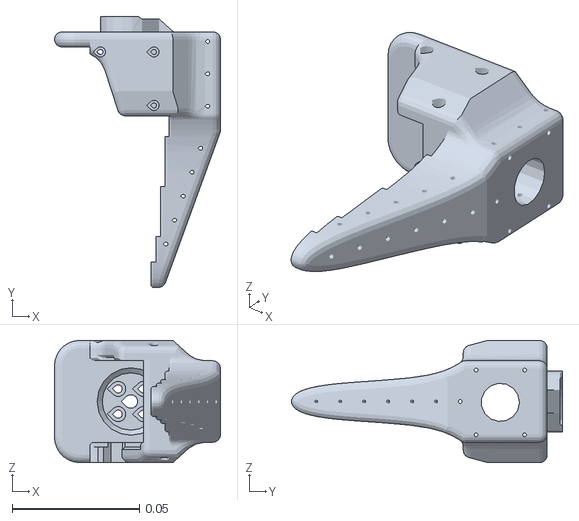
[picture p41: CAD file, 2026-11-08]
projects/web_sim/web/public/model_neck/meshes/Fixed_Jaw.stl
0.0652 x 0.106 x 0.048
