lauyihong/lerobotneck/projects/web_sim/web/public/model_neck/meshes/Moving_Jaw.stl

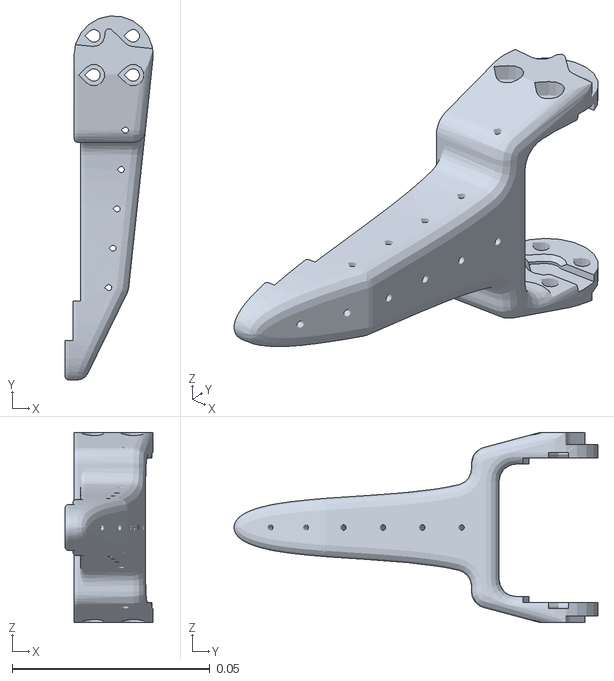
[picture p42: CAD file, 2026-11-08]
projects/web_sim/web/public/model_neck/meshes/Moving_Jaw.stl
0.0223 x 0.092 x 0.048
