lauyihong/lerobotneck/hardware/wallerobot_v0_1/urdf/meshes/topbase2.hull.stl

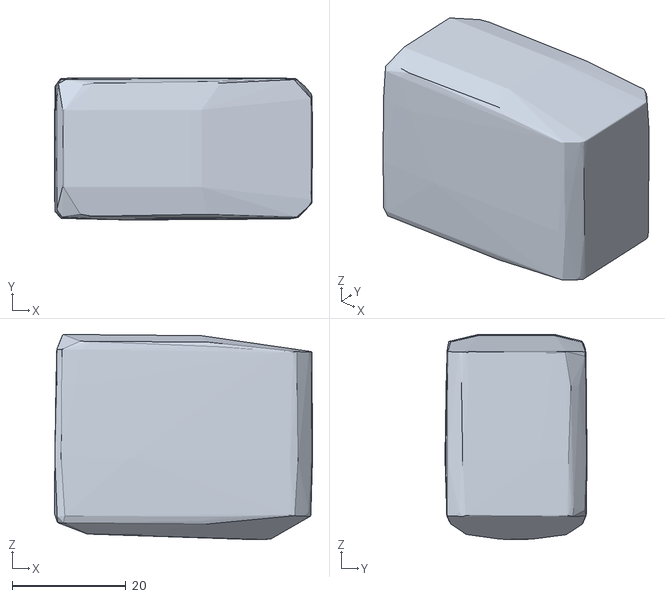
[picture p43: CAD file, 2026-11-08]
hardware/wallerobot_v0_1/urdf/meshes/topbase2.hull.stl
45.3 x 24.9 x 36.0
