lauyihong/lerobotneck/hardware/wallerobot_v0_1/urdf/meshes/base_j1_housing.hull.stl

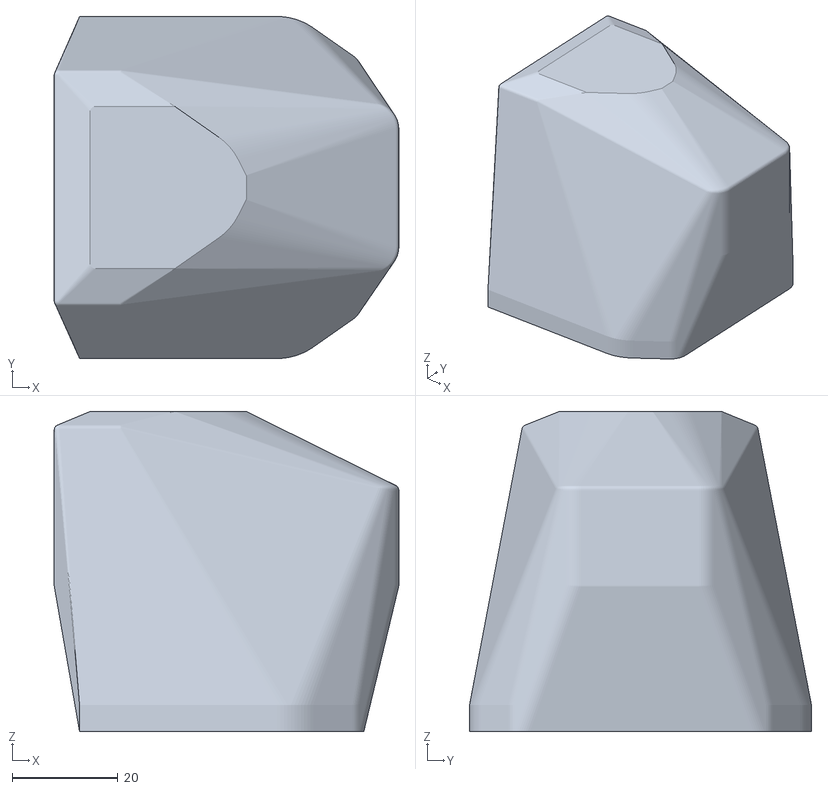
[picture p44: CAD file, 2026-11-08]
hardware/wallerobot_v0_1/urdf/meshes/base_j1_housing.hull.stl
65.2 x 64.7 x 60.5
