lauyihong/lerobotneck/projects/web_sim/web/public/model_neck/meshes/Lower_Arm.stl

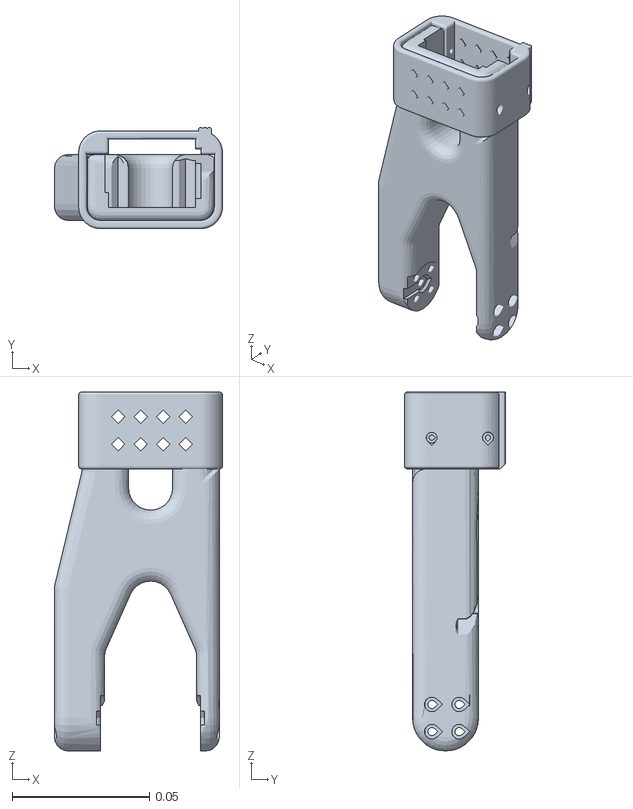
[picture p45: CAD file, 2026-11-08]
projects/web_sim/web/public/model_neck/meshes/Lower_Arm.stl
0.0612 x 0.0369 x 0.131
