lauyihong/lerobotneck/hardware/wallerobot_v0_1/urdf/meshes/Wrist_Pitch_Roll.hull.stl

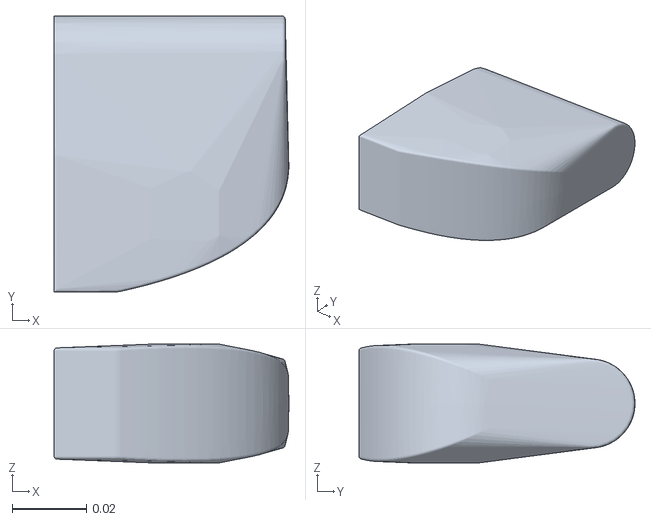
[picture p46: CAD file, 2026-11-08]
hardware/wallerobot_v0_1/urdf/meshes/Wrist_Pitch_Roll.hull.stl
0.0633 x 0.0744 x 0.032
