lauyihong/lerobotneck/projects/web_sim/web/public/model_neck/meshes/base_j1_housing.stl

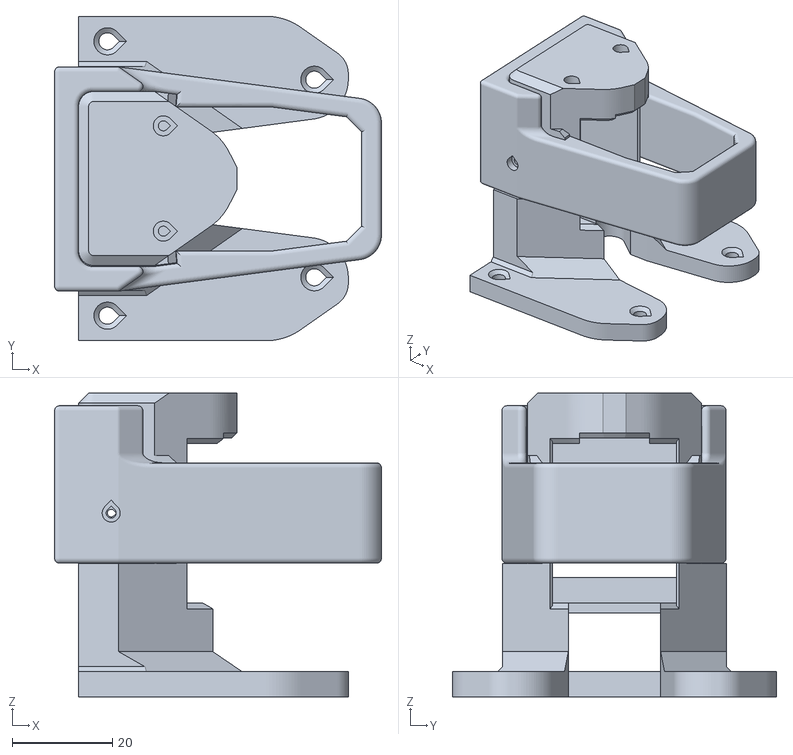
[picture p47: CAD file, 2026-11-08]
projects/web_sim/web/public/model_neck/meshes/base_j1_housing.stl
65.2 x 64.7 x 60.5
