lauyihong/lerobotneck/hardware/wallerobot_v0_1/urdf/meshes/tophead5.hull.stl

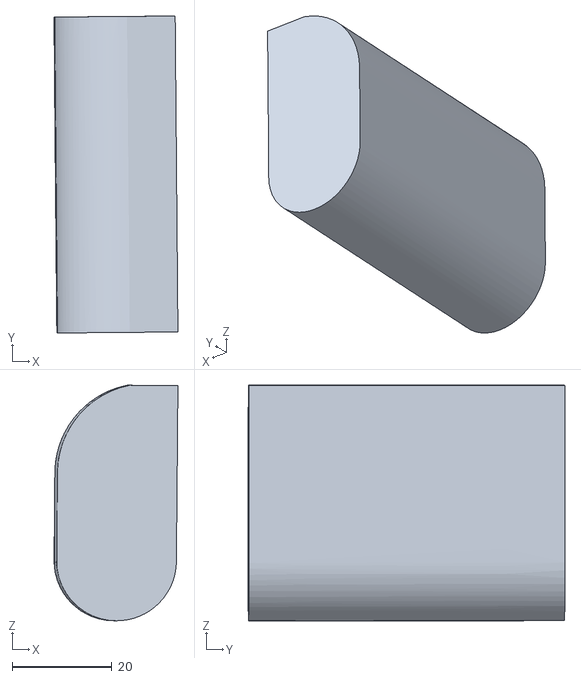
[picture p48: CAD file, 2026-11-08]
hardware/wallerobot_v0_1/urdf/meshes/tophead5.hull.stl
24.9 x 63.6 x 47.3
