lauyihong/lerobotneck/hardware/wallerobot_v0_1/urdf/meshes/Rotation_Pitch.hull.stl

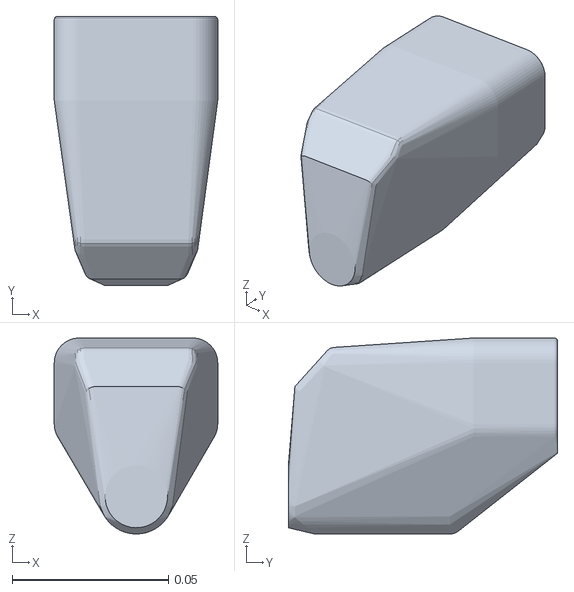
[picture p49: CAD file, 2026-11-08]
hardware/wallerobot_v0_1/urdf/meshes/Rotation_Pitch.hull.stl
0.0524 x 0.0863 x 0.0628
