lauyihong/lerobotneck/hardware/wallerobot_v0_1/urdf/meshes/tophead6.hull.stl

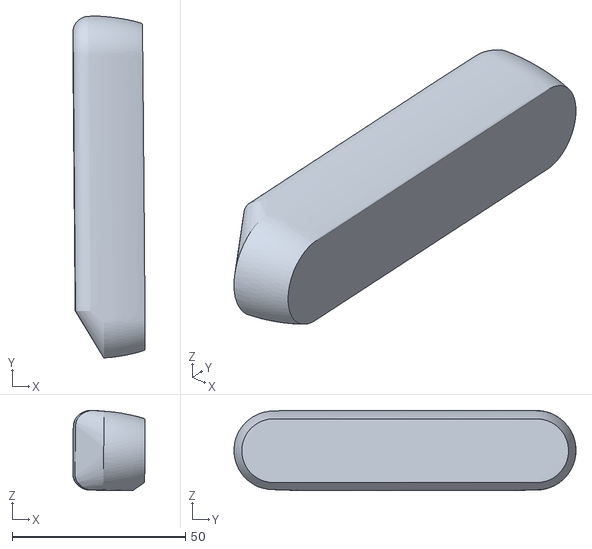
[picture p50: CAD file, 2026-11-08]
hardware/wallerobot_v0_1/urdf/meshes/tophead6.hull.stl
20.9 x 98.8 x 23.1
