lauyihong/lerobotneck/(list of files, cad)

Other CAD files:
projects/web_sim/web/public/model_neck/meshes/Lower_Arm_Motor.stl
hardware/neck_v0_1/urdf/meshes/Base_Motor.stl
projects/web_sim/web/public/model/meshes/Base_Motor.stl
projects/web_sim/web/public/model_neck/meshes/Fixed_Jaw_Motor.stl
hardware/upstream/xlerobot/meshes/Base_Motor.stl
projects/web_sim/web/public/model/meshes/Fixed_Jaw_Motor.hull.stl
hardware/wallerobot_v0_1/urdf/meshes/Upper_Arm_Motor.hull.stl
hardware/wallerobot_v0_1/urdf/meshes/Base_Motor.stl
hardware/wallerobot_v0_1/urdf/meshes/Rotation_Pitch_Motor.hull.stl
projects/web_sim/web/public/model_neck/meshes/topbase2.stl
projects/web_sim/web/public/model/meshes/Rotation_Pitch_Motor.hull.stl
projects/web_sim/web/public/model_neck/meshes/Rotation_Pitch_Motor.stl
projects/web_sim/web/public/model/meshes/Base_Motor.hull.stl
hardware/wallerobot_v0_1/urdf/meshes/Fixed_Jaw_Motor.hull.stl
projects/web_sim/web/public/model/meshes/base_body_lower.hull.stl
hardware/wallerobot_v0_1/urdf/meshes/base_body_lower.hull.stl
projects/web_sim/web/public/model/meshes/Upper_Arm_Motor.hull.stl
hardware/wallerobot_v0_1/urdf/meshes/Base_Motor.hull.stl
