lauyihong/lerobotneck/hardware/neck_v0_1/calib_guide.png

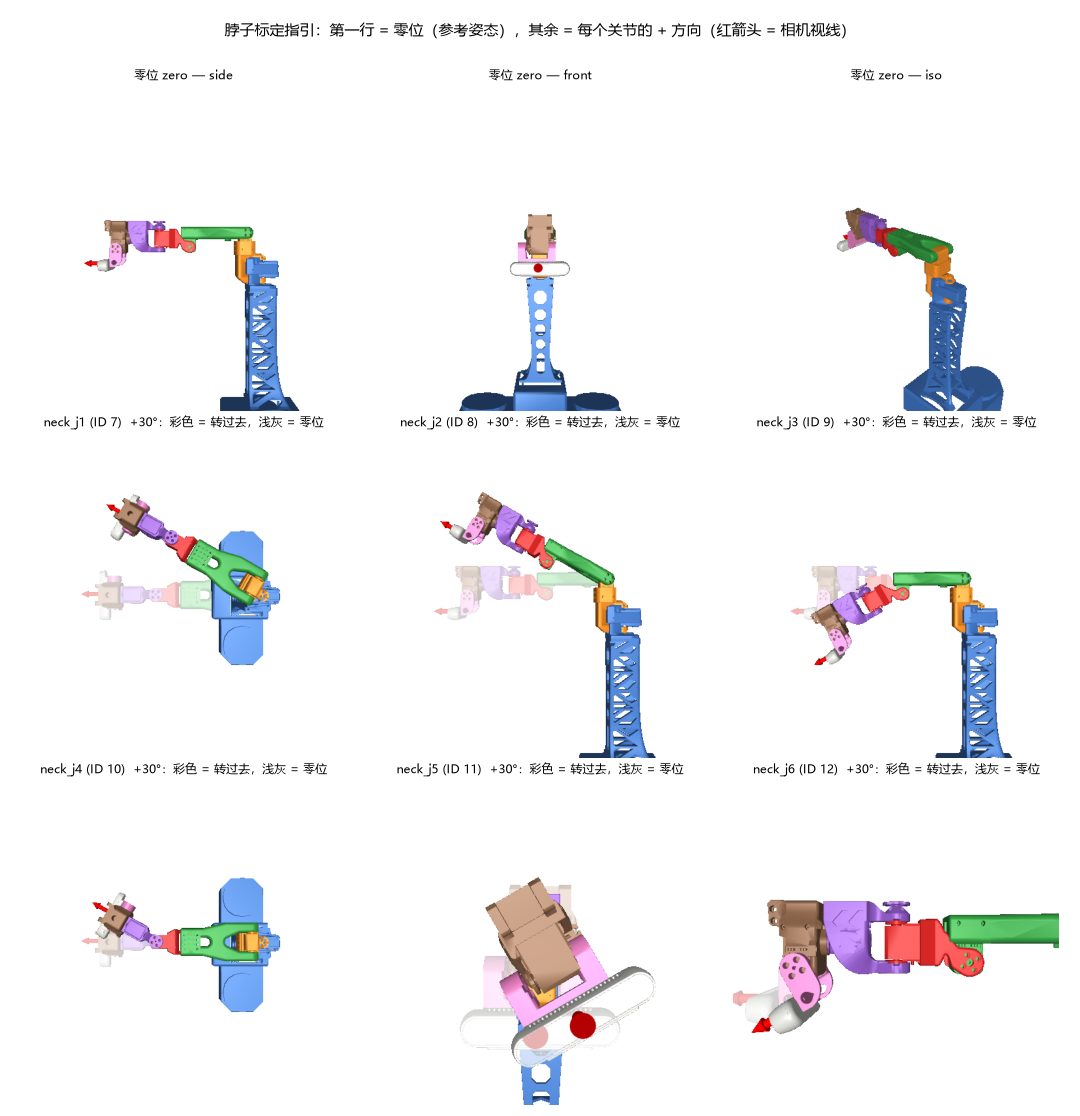
hardware/neck_v0_1/calib_guide.png
