lauyihong/lerobotneck/hardware/neck_v0_1/urdf/wallerobot_neck.urdf

<?xml version="1.0"?>
<!-- GENERATED by hardware/neck_v0_1/build_urdf.py - edit the script, not this file. Draft v0.1: see hardware/neck_v0_1/README.md for assumptions. -->
<robot name="wallerobot_neck">
  <mujoco>
    <compiler meshdir="meshes/" strippath="true" discardvisual="false" balanceinertia="true" />
  </mujoco>
  <link name="wallerobot_body">
    <inertial>
      <origin xyz="0 0 0" rpy="0 0 0" />
      <mass value="0.05" />
      <inertia ixx="1e-5" ixy="0" ixz="0" iyy="1e-5" iyz="0" izz="1e-5" />
    </inertial>
    <visual>
      <origin xyz="0.000000 0.000000 0.000000" rpy="0.000000 -0.000000 0.000000" />
      <geometry>
        <mesh filename="meshes/base_body_lower.stl" scale="0.001 0.001 0.001" />
      </geometry>
    </visual>
    <visual>
      <origin xyz="0.000000 0.000000 0.000000" rpy="0.000000 -0.000000 0.000000" />
      <geometry>
        <mesh filename="meshes/base_tower.stl" scale="0.001 0.001 0.001" />
      </geometry>
    </visual>
    <visual>
      <origin xyz="0.000000 0.000000 0.000000" rpy="0.000000 -0.000000 0.000000" />
      <geometry>
        <mesh filename="meshes/base_j1_housing.stl" scale="0.001 0.001 0.001" />
      </geometry>
    </visual>
    <visual>
      <origin xyz="-0.298000 0.006000 -0.715000" rpy="0.000000 -0.000000 3.140000" />
      <geometry>
        <mesh filename="meshes/topbase2.stl" scale="0.001 0.001 0.001" />
      </geometry>
    </visual>
  </link>
  <link name="neck_base">
    <inertial>
      <origin xyz="0 0 0" rpy="0 0 0" />
      <mass value="0.001" />
      <inertia ixx="1e-5" ixy="0" ixz="0" iyy="1e-5" iyz="0" izz="1e-5" />
    </inertial>
  </link>
  <link name="neck_shoulder">
    <inertial>
      <origin xyz="0 0 0" rpy="0 0 0" />
      <mass value="0.05" />
      <inertia ixx="1e-5" ixy="0" ixz="0" iyy="1e-5" iyz="0" izz="1e-5" />
    </inertial>
    <visual>
      <origin xyz="0.000000 0.000000 0.000000" rpy="0.000000 -0.000000 0.000000" />
      <geometry>
        <mesh filename="meshes/Rotation_Pitch.stl" />
      </geometry>
    </visual>
    <visual>
      <origin xyz="0.000000 0.000000 0.000000" rpy="0.000000 -0.000000 0.000000" />
      <geometry>
        <mesh filename="meshes/Rotation_Pitch_Motor.stl" />
      </geometry>
    </visual>
  </link>
  <link name="neck_upper_arm">
    <inertial>
      <origin xyz="0 0 0" rpy="0 0 0" />
      <mass value="0.05" />
      <inertia ixx="1e-5" ixy="0" ixz="0" iyy="1e-5" iyz="0" izz="1e-5" />
    </inertial>
    <visual>
      <origin xyz="0.000000 0.000000 0.000000" rpy="0.000000 -0.000000 0.000000" />
      <geometry>
        <mesh filename="meshes/Upper_Arm.stl" />
      </geometry>
    </visual>
    <visual>
      <origin xyz="0.000000 0.000000 0.000000" rpy="0.000000 -0.000000 0.000000" />
      <geometry>
        <mesh filename="meshes/Upper_Arm_Motor.stl" />
      </geometry>
    </visual>
  </link>
  <link name="neck_link34">
    <inertial>
      <origin xyz="0 0 0" rpy="0 0 0" />
      <mass value="0.05" />
      <inertia ixx="1e-5" ixy="0" ixz="0" iyy="1e-5" iyz="0" izz="1e-5" />
    </inertial>
    <visual>
      <origin xyz="0.023200 -0.012000 0.041000" rpy="-1.570796 1.570796 0.000000" />
      <geometry>
        <mesh filename="meshes/wallerobot_new_wrist_dof_0_1.stl" scale="0.001 0.001 0.001" />
      </geometry>
    </visual>
    <visual>
      <origin xyz="-0.005900 0.016850 -0.073700" rpy="0.000000 -0.000000 -1.570796" />
      <geometry>
        <mesh filename="meshes/Lower_Arm_Motor.stl" />
      </geometry>
    </visual>
  </link>
  <link name="neck_wrist">
    <inertial>
      <origin xyz="0 0 0" rpy="0 0 0" />
      <mass value="0.05" />
      <inertia ixx="1e-5" ixy="0" ixz="0" iyy="1e-5" iyz="0" izz="1e-5" />
    </inertial>
    <visual>
      <origin xyz="0.000000 0.000000 0.000000" rpy="0.000000 -0.000000 0.000000" />
      <geometry>
        <mesh filename="meshes/Wrist_Pitch_Roll.stl" />
      </geometry>
    </visual>
    <visual>
      <origin xyz="0.000000 0.000000 0.000000" rpy="0.000000 -0.000000 0.000000" />
      <geometry>
        <mesh filename="meshes/Wrist_Pitch_Roll_Motor.stl" />
      </geometry>
    </visual>
  </link>
  <link name="neck_cam_tilt_housing">
    <inertial>
      <origin xyz="0 0 0" rpy="0 0 0" />
      <mass value="0.05" />
      <inertia ixx="1e-5" ixy="0" ixz="0" iyy="1e-5" iyz="0" izz="1e-5" />
    </inertial>
    <visual>
      <origin xyz="0.035530 -0.200750 -0.079850" rpy="-0.000000 -1.570796 0.000000" />
      <geometry>
        <mesh filename="meshes/cam_tilt_housing_softfin.stl" scale="0.001 0.001 0.001" />
      </geometry>
    </visual>
    <visual>
      <origin xyz="0.000000 0.000000 0.000000" rpy="0.000000 -0.000000 0.000000" />
      <geometry>
        <mesh filename="meshes/Fixed_Jaw_Motor.stl" />
      </geometry>
    </visual>
  </link>
  <link name="neck_cam_holder">
    <inertial>
      <origin xyz="0 0 0" rpy="0 0 0" />
      <mass value="0.05" />
      <inertia ixx="1e-5" ixy="0" ixz="0" iyy="1e-5" iyz="0" izz="1e-5" />
    </inertial>
    <visual>
      <origin xyz="-1.177942 0.059017 0.003500" rpy="-1.570796 -0.000000 -1.759204" />
      <geometry>
        <mesh filename="meshes/tophead5.stl" scale="0.001 0.001 0.001" />
      </geometry>
    </visual>
    <visual>
      <origin xyz="1.175953 -0.389798 -0.008500" rpy="1.570796 0.000000 -1.759204" />
      <geometry>
        <mesh filename="meshes/tophead6.stl" scale="0.001 0.001 0.001" />
      </geometry>
    </visual>
  </link>
  <link name="neck_camera_link">
    <inertial>
      <origin xyz="0 0 0" rpy="0 0 0" />
      <mass value="0.001" />
      <inertia ixx="1e-5" ixy="0" ixz="0" iyy="1e-5" iyz="0" izz="1e-5" />
    </inertial>
  </link>
  <link name="neck_camera_color_optical_frame">
    <inertial>
      <origin xyz="0 0 0" rpy="0 0 0" />
      <mass value="0.001" />
      <inertia ixx="1e-5" ixy="0" ixz="0" iyy="1e-5" iyz="0" izz="1e-5" />
    </inertial>
  </link>
  <joint name="neck_mount" type="fixed">
    <parent link="wallerobot_body" />
    <child link="neck_base" />
    <origin xyz="-0.058920 -0.000220 0.335160" rpy="0.000000 -0.000000 -1.570796" />
  </joint>
  <joint name="neck_j1" type="revolute">
    <parent link="neck_base" />
    <child link="neck_shoulder" />
    <origin xyz="0.000000 -0.045200 0.016500" rpy="1.570800 -0.000000 0.000000" />
    <axis xyz="0 -1 0" />
    <limit lower="-1.5493" upper="1.9405" effort="3.35" velocity="3" />
  </joint>
  <joint name="neck_j2" type="revolute">
    <parent link="neck_shoulder" />
    <child link="neck_upper_arm" />
    <origin xyz="0.000000 0.102500 0.030600" rpy="1.570800 -0.000000 0.000000" />
    <axis xyz="-1 0 0" />
    <limit lower="-0.2730" upper="3.2628" effort="3.35" velocity="3" />
  </joint>
  <joint name="neck_j3" type="revolute">
    <parent link="neck_upper_arm" />
    <child link="neck_link34" />
    <origin xyz="0.000000 0.112570 0.028000" rpy="-1.570800 -0.000000 0.000000" />
    <axis xyz="1 0 0" />
    <limit lower="0.5123" upper="3.1539" effort="3.35" velocity="3" />
  </joint>
  <joint name="neck_j4" type="revolute">
    <parent link="neck_link34" />
    <child link="neck_wrist" />
    <origin xyz="-0.000700 0.016850 0.061200" rpy="-1.570800 -0.000000 -1.570796" />
    <axis xyz="1 0 0" />
    <limit lower="-1.7564" upper="1.7426" effort="3.35" velocity="3" />
  </joint>
  <joint name="neck_j5" type="revolute">
    <parent link="neck_wrist" />
    <child link="neck_cam_tilt_housing" />
    <origin xyz="0.000000 -0.060100 0.000000" rpy="3.141593 0.000004 3.141593" />
    <axis xyz="0 -1 0" />
    <limit lower="-4.4808" upper="1.2425" effort="3.35" velocity="3" />
  </joint>
  <joint name="neck_j6" type="revolute">
    <parent link="neck_cam_tilt_housing" />
    <child link="neck_cam_holder" />
    <origin xyz="-0.020200 -0.024400 0.000000" rpy="3.141585 -0.000001 2.953185" />
    <axis xyz="0 0 1" />
    <limit lower="-1.3990" upper="1.1904" effort="3.35" velocity="3" />
  </joint>
  <joint name="neck_camera_joint" type="fixed">
    <parent link="neck_cam_holder" />
    <child link="neck_camera_link" />
    <origin xyz="0.024787 -0.030176 -0.002500" rpy="1.570796 -0.000000 -1.759204" />
  </joint>
  <joint name="neck_camera_color_optical_joint" type="fixed">
    <parent link="neck_camera_link" />
    <child link="neck_camera_color_optical_frame" />
    <origin xyz="0.000000 0.000000 0.000000" rpy="-1.570796 -0.000000 -1.570796" />
  </joint>
</robot>
