lauyihong/lerobotneck/hardware/wallerobot_v0_1/urdf/wallerobot_static.urdf

<?xml version="1.0"?>
<!-- GENERATED by hardware/wallerobot_v0_1/build_full_urdf.py - edit the script, not this file. See hardware/wallerobot_v0_1/README.md for assumptions. -->
<robot name="wallerobot_static">
  <mujoco>
    <compiler meshdir="meshes/" strippath="true" discardvisual="false" balanceinertia="true" />
  </mujoco>
  <link name="wallerobot_body">
    <inertial>
      <origin xyz="0 0 0" rpy="0 0 0" />
      <mass value="0.05" />
      <inertia ixx="1e-5" ixy="0" ixz="0" iyy="1e-5" iyz="0" izz="1e-5" />
    </inertial>
    <visual>
      <origin xyz="0.000000 0.000000 0.000000" rpy="0.000000 -0.000000 0.000000" />
      <geometry>
        <mesh filename="meshes/base_body_lower.stl" scale="0.001 0.001 0.001" />
      </geometry>
    </visual>
    <visual>
      <origin xyz="0.000000 0.000000 0.000000" rpy="0.000000 -0.000000 0.000000" />
      <geometry>
        <mesh filename="meshes/base_tower.stl" scale="0.001 0.001 0.001" />
      </geometry>
    </visual>
    <visual>
      <origin xyz="0.000000 0.000000 0.000000" rpy="0.000000 -0.000000 0.000000" />
      <geometry>
        <mesh filename="meshes/base_j1_housing.stl" scale="0.001 0.001 0.001" />
      </geometry>
    </visual>
    <visual>
      <origin xyz="-0.298000 0.006000 -0.715000" rpy="0.000000 -0.000000 3.140000" />
      <geometry>
        <mesh filename="meshes/topbase2.stl" scale="0.001 0.001 0.001" />
      </geometry>
    </visual>
    <collision>
      <origin xyz="0.000000 0.000000 0.000000" rpy="0.000000 -0.000000 0.000000" />
      <geometry>
        <mesh filename="meshes/base_body_lower.hull.stl" scale="0.001 0.001 0.001" />
      </geometry>
    </collision>
    <collision>
      <origin xyz="0.000000 0.000000 0.000000" rpy="0.000000 -0.000000 0.000000" />
      <geometry>
        <mesh filename="meshes/base_tower.hull.stl" scale="0.001 0.001 0.001" />
      </geometry>
    </collision>
    <collision>
      <origin xyz="0.000000 0.000000 0.000000" rpy="0.000000 -0.000000 0.000000" />
      <geometry>
        <mesh filename="meshes/base_j1_housing.hull.stl" scale="0.001 0.001 0.001" />
      </geometry>
    </collision>
    <collision>
      <origin xyz="-0.298000 0.006000 -0.715000" rpy="0.000000 -0.000000 3.140000" />
      <geometry>
        <mesh filename="meshes/topbase2.hull.stl" scale="0.001 0.001 0.001" />
      </geometry>
    </collision>
  </link>
  <link name="neck_base">
    <inertial>
      <origin xyz="0 0 0" rpy="0 0 0" />
      <mass value="0.001" />
      <inertia ixx="1e-5" ixy="0" ixz="0" iyy="1e-5" iyz="0" izz="1e-5" />
    </inertial>
  </link>
  <link name="neck_shoulder">
    <inertial>
      <origin xyz="0 0 0" rpy="0 0 0" />
      <mass value="0.05" />
      <inertia ixx="1e-5" ixy="0" ixz="0" iyy="1e-5" iyz="0" izz="1e-5" />
    </inertial>
    <visual>
      <origin xyz="0.000000 0.000000 0.000000" rpy="0.000000 -0.000000 0.000000" />
      <geometry>
        <mesh filename="meshes/Rotation_Pitch.stl" />
      </geometry>
    </visual>
    <visual>
      <origin xyz="0.000000 0.000000 0.000000" rpy="0.000000 -0.000000 0.000000" />
      <geometry>
        <mesh filename="meshes/Rotation_Pitch_Motor.stl" />
      </geometry>
    </visual>
    <collision>
      <origin xyz="0.000000 0.000000 0.000000" rpy="0.000000 -0.000000 0.000000" />
      <geometry>
        <mesh filename="meshes/Rotation_Pitch.hull.stl" />
      </geometry>
    </collision>
    <collision>
      <origin xyz="0.000000 0.000000 0.000000" rpy="0.000000 -0.000000 0.000000" />
      <geometry>
        <mesh filename="meshes/Rotation_Pitch_Motor.hull.stl" />
      </geometry>
    </collision>
  </link>
  <link name="neck_upper_arm">
    <inertial>
      <origin xyz="0 0 0" rpy="0 0 0" />
      <mass value="0.05" />
      <inertia ixx="1e-5" ixy="0" ixz="0" iyy="1e-5" iyz="0" izz="1e-5" />
    </inertial>
    <visual>
      <origin xyz="0.000000 0.000000 0.000000" rpy="0.000000 -0.000000 0.000000" />
      <geometry>
        <mesh filename="meshes/Upper_Arm.stl" />
      </geometry>
    </visual>
    <visual>
      <origin xyz="0.000000 0.000000 0.000000" rpy="0.000000 -0.000000 0.000000" />
      <geometry>
        <mesh filename="meshes/Upper_Arm_Motor.stl" />
      </geometry>
    </visual>
    <collision>
      <origin xyz="0.000000 0.000000 0.000000" rpy="0.000000 -0.000000 0.000000" />
      <geometry>
        <mesh filename="meshes/Upper_Arm.hull.stl" />
      </geometry>
    </collision>
    <collision>
      <origin xyz="0.000000 0.000000 0.000000" rpy="0.000000 -0.000000 0.000000" />
      <geometry>
        <mesh filename="meshes/Upper_Arm_Motor.hull.stl" />
      </geometry>
    </collision>
  </link>
  <link name="neck_link34">
    <inertial>
      <origin xyz="0 0 0" rpy="0 0 0" />
      <mass value="0.05" />
      <inertia ixx="1e-5" ixy="0" ixz="0" iyy="1e-5" iyz="0" izz="1e-5" />
    </inertial>
    <visual>
      <origin xyz="0.023200 -0.012000 0.041000" rpy="-1.570796 1.570796 0.000000" />
      <geometry>
        <mesh filename="meshes/wallerobot_new_wrist_dof_0_1.stl" scale="0.001 0.001 0.001" />
      </geometry>
    </visual>
    <visual>
      <origin xyz="-0.005900 0.016850 -0.073700" rpy="0.000000 -0.000000 -1.570796" />
      <geometry>
        <mesh filename="meshes/Lower_Arm_Motor.stl" />
      </geometry>
    </visual>
    <collision>
      <origin xyz="0.023200 -0.012000 0.041000" rpy="-1.570796 1.570796 0.000000" />
      <geometry>
        <mesh filename="meshes/wallerobot_new_wrist_dof_0_1.hull.stl" scale="0.001 0.001 0.001" />
      </geometry>
    </collision>
    <collision>
      <origin xyz="-0.005900 0.016850 -0.073700" rpy="0.000000 -0.000000 -1.570796" />
      <geometry>
        <mesh filename="meshes/Lower_Arm_Motor.hull.stl" />
      </geometry>
    </collision>
  </link>
  <link name="neck_wrist">
    <inertial>
      <origin xyz="0 0 0" rpy="0 0 0" />
      <mass value="0.05" />
      <inertia ixx="1e-5" ixy="0" ixz="0" iyy="1e-5" iyz="0" izz="1e-5" />
    </inertial>
    <visual>
      <origin xyz="0.000000 0.000000 0.000000" rpy="0.000000 -0.000000 0.000000" />
      <geometry>
        <mesh filename="meshes/Wrist_Pitch_Roll.stl" />
      </geometry>
    </visual>
    <visual>
      <origin xyz="0.000000 0.000000 0.000000" rpy="0.000000 -0.000000 0.000000" />
      <geometry>
        <mesh filename="meshes/Wrist_Pitch_Roll_Motor.stl" />
      </geometry>
    </visual>
    <collision>
      <origin xyz="0.000000 0.000000 0.000000" rpy="0.000000 -0.000000 0.000000" />
      <geometry>
        <mesh filename="meshes/Wrist_Pitch_Roll.hull.stl" />
      </geometry>
    </collision>
    <collision>
      <origin xyz="0.000000 0.000000 0.000000" rpy="0.000000 -0.000000 0.000000" />
      <geometry>
        <mesh filename="meshes/Wrist_Pitch_Roll_Motor.hull.stl" />
      </geometry>
    </collision>
  </link>
  <link name="neck_cam_tilt_housing">
    <inertial>
      <origin xyz="0 0 0" rpy="0 0 0" />
      <mass value="0.05" />
      <inertia ixx="1e-5" ixy="0" ixz="0" iyy="1e-5" iyz="0" izz="1e-5" />
    </inertial>
    <visual>
      <origin xyz="0.035530 -0.200750 -0.079850" rpy="-0.000000 -1.570796 0.000000" />
      <geometry>
        <mesh filename="meshes/cam_tilt_housing_softfin.stl" scale="0.001 0.001 0.001" />
      </geometry>
    </visual>
    <visual>
      <origin xyz="0.000000 0.000000 0.000000" rpy="0.000000 -0.000000 0.000000" />
      <geometry>
        <mesh filename="meshes/Fixed_Jaw_Motor.stl" />
      </geometry>
    </visual>
    <collision>
      <origin xyz="0.035530 -0.200750 -0.079850" rpy="-0.000000 -1.570796 0.000000" />
      <geometry>
        <mesh filename="meshes/cam_tilt_housing_softfin.hull.stl" scale="0.001 0.001 0.001" />
      </geometry>
    </collision>
    <collision>
      <origin xyz="0.000000 0.000000 0.000000" rpy="0.000000 -0.000000 0.000000" />
      <geometry>
        <mesh filename="meshes/Fixed_Jaw_Motor.hull.stl" />
      </geometry>
    </collision>
  </link>
  <link name="neck_cam_holder">
    <inertial>
      <origin xyz="0 0 0" rpy="0 0 0" />
      <mass value="0.05" />
      <inertia ixx="1e-5" ixy="0" ixz="0" iyy="1e-5" iyz="0" izz="1e-5" />
    </inertial>
    <visual>
      <origin xyz="-1.177942 0.059017 0.003500" rpy="-1.570796 -0.000000 -1.759204" />
      <geometry>
        <mesh filename="meshes/tophead5.stl" scale="0.001 0.001 0.001" />
      </geometry>
    </visual>
    <visual>
      <origin xyz="1.175953 -0.389798 -0.008500" rpy="1.570796 0.000000 -1.759204" />
      <geometry>
        <mesh filename="meshes/tophead6.stl" scale="0.001 0.001 0.001" />
      </geometry>
    </visual>
    <collision>
      <origin xyz="-1.177942 0.059017 0.003500" rpy="-1.570796 -0.000000 -1.759204" />
      <geometry>
        <mesh filename="meshes/tophead5.hull.stl" scale="0.001 0.001 0.001" />
      </geometry>
    </collision>
    <collision>
      <origin xyz="1.175953 -0.389798 -0.008500" rpy="1.570796 0.000000 -1.759204" />
      <geometry>
        <mesh filename="meshes/tophead6.hull.stl" scale="0.001 0.001 0.001" />
      </geometry>
    </collision>
  </link>
  <link name="neck_camera_link">
    <inertial>
      <origin xyz="0 0 0" rpy="0 0 0" />
      <mass value="0.001" />
      <inertia ixx="1e-5" ixy="0" ixz="0" iyy="1e-5" iyz="0" izz="1e-5" />
    </inertial>
  </link>
  <link name="neck_camera_color_optical_frame">
    <inertial>
      <origin xyz="0 0 0" rpy="0 0 0" />
      <mass value="0.001" />
      <inertia ixx="1e-5" ixy="0" ixz="0" iyy="1e-5" iyz="0" izz="1e-5" />
    </inertial>
  </link>
  <joint name="neck_mount" type="fixed">
    <parent link="wallerobot_body" />
    <child link="neck_base" />
    <origin xyz="-0.058920 -0.000220 0.335160" rpy="0.000000 -0.000000 -1.570796" />
  </joint>
  <joint name="neck_j1" type="revolute">
    <parent link="neck_base" />
    <child link="neck_shoulder" />
    <origin xyz="0.000000 -0.045200 0.016500" rpy="1.570800 -0.000000 0.000000" />
    <axis xyz="0 -1 0" />
    <limit lower="-1.5493" upper="1.9405" effort="3.35" velocity="3" />
  </joint>
  <joint name="neck_j2" type="revolute">
    <parent link="neck_shoulder" />
    <child link="neck_upper_arm" />
    <origin xyz="0.000000 0.102500 0.030600" rpy="1.570800 -0.000000 0.000000" />
    <axis xyz="-1 0 0" />
    <limit lower="-0.2730" upper="3.2628" effort="3.35" velocity="3" />
  </joint>
  <joint name="neck_j3" type="revolute">
    <parent link="neck_upper_arm" />
    <child link="neck_link34" />
    <origin xyz="0.000000 0.112570 0.028000" rpy="-1.570800 -0.000000 0.000000" />
    <axis xyz="1 0 0" />
    <limit lower="0.5123" upper="3.1539" effort="3.35" velocity="3" />
  </joint>
  <joint name="neck_j4" type="revolute">
    <parent link="neck_link34" />
    <child link="neck_wrist" />
    <origin xyz="-0.000700 0.016850 0.061200" rpy="-1.570800 -0.000000 -1.570796" />
    <axis xyz="1 0 0" />
    <limit lower="-1.7564" upper="1.7426" effort="3.35" velocity="3" />
  </joint>
  <joint name="neck_j5" type="revolute">
    <parent link="neck_wrist" />
    <child link="neck_cam_tilt_housing" />
    <origin xyz="0.000000 -0.060100 0.000000" rpy="3.141593 0.000004 3.141593" />
    <axis xyz="0 -1 0" />
    <limit lower="-4.4808" upper="1.2425" effort="3.35" velocity="3" />
  </joint>
  <joint name="neck_j6" type="revolute">
    <parent link="neck_cam_tilt_housing" />
    <child link="neck_cam_holder" />
    <origin xyz="-0.020200 -0.024400 0.000000" rpy="3.141585 -0.000001 2.953185" />
    <axis xyz="0 0 1" />
    <limit lower="-1.3990" upper="1.1904" effort="3.35" velocity="3" />
  </joint>
  <joint name="neck_camera_joint" type="fixed">
    <parent link="neck_cam_holder" />
    <child link="neck_camera_link" />
    <origin xyz="0.024787 -0.030176 -0.002500" rpy="1.570796 -0.000000 -1.759204" />
  </joint>
  <joint name="neck_camera_color_optical_joint" type="fixed">
    <parent link="neck_camera_link" />
    <child link="neck_camera_color_optical_frame" />
    <origin xyz="0.000000 0.000000 0.000000" rpy="-1.570796 -0.000000 -1.570796" />
  </joint>
  <link name="left_arm_base">
    <visual>
      <origin xyz="0.000000 0.000000 0.000000" rpy="0.000000 -0.000000 0.000000" />
      <geometry>
        <mesh filename="meshes/Base.stl" />
      </geometry>
      <material name="left_arm_base_Base.stl">
        <color rgba="0.85 0.85 0.85 1" />
      </material>
    </visual>
    <visual>
      <origin xyz="0.000000 0.000000 0.000000" rpy="0.000000 -0.000000 0.000000" />
      <geometry>
        <mesh filename="meshes/Base_Motor.stl" />
      </geometry>
      <material name="left_arm_base_Base_Motor.stl">
        <color rgba="0.1 0.1 0.1 1" />
      </material>
    </visual>
    <collision>
      <origin xyz="0.000000 0.000000 0.000000" rpy="0.000000 -0.000000 0.000000" />
      <geometry>
        <mesh filename="meshes/Base_Motor.hull.stl" />
      </geometry>
    </collision>
    <collision>
      <origin xyz="0.000000 0.000000 0.000000" rpy="0.000000 -0.000000 0.000000" />
      <geometry>
        <mesh filename="meshes/Base.hull.stl" />
      </geometry>
    </collision>
    <inertial>
      <origin xyz="0.0137179 -0.000052 0.0334843" rpy="0 0 0" />
      <mass value="0.147" />
      <inertia ixx="0.0001147" ixy="-0.0000005" ixz="0.000005" iyy="0.0001361" iyz="0.0000001" izz="0.0001304" />
    </inertial>
  </link>
  <link name="left_arm_shoulder">
    <visual>
      <origin xyz="0.000000 0.000000 0.000000" rpy="0.000000 -0.000000 0.000000" />
      <geometry>
        <mesh filename="meshes/Rotation_Pitch.stl" />
      </geometry>
      <material name="left_arm_shoulder_Rotation_Pitch.stl">
        <color rgba="0.85 0.85 0.85 1" />
      </material>
    </visual>
    <visual>
      <origin xyz="0.000000 0.000000 0.000000" rpy="0.000000 -0.000000 0.000000" />
      <geometry>
        <mesh filename="meshes/Rotation_Pitch_Motor.stl" />
      </geometry>
      <material name="left_arm_shoulder_Rotation_Pitch_Motor.stl">
        <color rgba="0.1 0.1 0.1 1" />
      </material>
    </visual>
    <collision>
      <origin xyz="0.000000 0.000000 0.000000" rpy="0.000000 -0.000000 0.000000" />
      <geometry>
        <mesh filename="meshes/Rotation_Pitch_Motor.hull.stl" />
      </geometry>
    </collision>
    <collision>
      <origin xyz="0.000000 0.000000 0.000000" rpy="0.000000 -0.000000 0.000000" />
      <geometry>
        <mesh filename="meshes/Rotation_Pitch.hull.stl" />
      </geometry>
    </collision>
    <inertial>
      <origin xyz="-0.0307604 -0.0000167 -0.0252713" rpy="0 0 0" />
      <mass value="0.100006" />
      <inertia ixx="0.0000838" ixy="0.0000001" ixz="-0.0000012" iyy="0.000081" iyz="0.0000002" izz="0.000024" />
    </inertial>
  </link>
  <link name="left_arm_upper_arm">
    <visual>
      <origin xyz="0.000000 0.000000 0.000000" rpy="0.000000 -0.000000 0.000000" />
      <geometry>
        <mesh filename="meshes/Upper_Arm.stl" />
      </geometry>
      <material name="left_arm_upper_arm_Upper_Arm.stl">
        <color rgba="0.85 0.85 0.85 1" />
      </material>
    </visual>
    <visual>
      <origin xyz="0.000000 0.000000 0.000000" rpy="0.000000 -0.000000 0.000000" />
      <geometry>
        <mesh filename="meshes/Upper_Arm_Motor.stl" />
      </geometry>
      <material name="left_arm_upper_arm_Upper_Arm_Motor.stl">
        <color rgba="0.1 0.1 0.1 1" />
      </material>
    </visual>
    <collision>
      <origin xyz="0.000000 0.000000 0.000000" rpy="0.000000 -0.000000 0.000000" />
      <geometry>
        <mesh filename="meshes/Upper_Arm_Motor.hull.stl" />
      </geometry>
    </collision>
    <collision>
      <origin xyz="0.000000 0.000000 0.000000" rpy="0.000000 -0.000000 0.000000" />
      <geometry>
        <mesh filename="meshes/Upper_Arm.hull.stl" />
      </geometry>
    </collision>
    <inertial>
      <origin xyz="-0.0898471 -0.0083822 0.0184089" rpy="0 0 0" />
      <mass value="0.103" />
      <inertia ixx="0.0000408" ixy="-0.0000198" ixz="0" iyy="0.0001473" iyz="0" izz="0.0001425" />
    </inertial>
  </link>
  <link name="left_arm_lower_arm">
    <visual>
      <origin xyz="0.000000 0.000000 0.000000" rpy="0.000000 -0.000000 0.000000" />
      <geometry>
        <mesh filename="meshes/Lower_Arm.stl" />
      </geometry>
      <material name="left_arm_lower_arm_Lower_Arm.stl">
        <color rgba="0.85 0.85 0.85 1" />
      </material>
    </visual>
    <visual>
      <origin xyz="0.000000 0.000000 0.000000" rpy="0.000000 -0.000000 0.000000" />
      <geometry>
        <mesh filename="meshes/Lower_Arm_Motor.stl" />
      </geometry>
      <material name="left_arm_lower_arm_Lower_Arm_Motor.stl">
        <color rgba="0.1 0.1 0.1 1" />
      </material>
    </visual>
    <collision>
      <origin xyz="0.000000 0.000000 0.000000" rpy="0.000000 -0.000000 0.000000" />
      <geometry>
        <mesh filename="meshes/Lower_Arm_Motor.hull.stl" />
      </geometry>
    </collision>
    <collision>
      <origin xyz="0.000000 0.000000 0.000000" rpy="0.000000 -0.000000 0.000000" />
      <geometry>
        <mesh filename="meshes/Lower_Arm.hull.stl" />
      </geometry>
    </collision>
    <inertial>
      <origin xyz="-0.0980701 0.0032438 0.0182831" rpy="0 0 0" />
      <mass value="0.104" />
      <inertia ixx="0.0000287" ixy="0.0000074" ixz="0.0000013" iyy="0.0001598" iyz="0" izz="0.0001453" />
    </inertial>
  </link>
  <link name="left_arm_wrist">
    <visual>
      <origin xyz="0.000000 0.000000 0.000000" rpy="0.000000 -0.000000 0.000000" />
      <geometry>
        <mesh filename="meshes/Wrist_Pitch_Roll.stl" />
      </geometry>
      <material name="left_arm_wrist_Wrist_Pitch_Roll.stl">
        <color rgba="0.85 0.85 0.85 1" />
      </material>
    </visual>
    <visual>
      <origin xyz="0.000000 0.000000 0.000000" rpy="0.000000 -0.000000 0.000000" />
      <geometry>
        <mesh filename="meshes/Wrist_Pitch_Roll_Motor.stl" />
      </geometry>
      <material name="left_arm_wrist_Wrist_Pitch_Roll_Motor.stl">
        <color rgba="0.1 0.1 0.1 1" />
      </material>
    </visual>
    <collision>
      <origin xyz="0.000000 0.000000 0.000000" rpy="0.000000 -0.000000 0.000000" />
      <geometry>
        <mesh filename="meshes/Wrist_Pitch_Roll_Motor.hull.stl" />
      </geometry>
    </collision>
    <collision>
      <origin xyz="0.000000 0.000000 0.000000" rpy="0.000000 -0.000000 0.000000" />
      <geometry>
        <mesh filename="meshes/Wrist_Pitch_Roll.hull.stl" />
      </geometry>
    </collision>
    <inertial>
      <origin xyz="-0.0001033 -0.0386143 0.0281156" rpy="0 0 0" />
      <mass value="0.079" />
      <inertia ixx="0.0000368" ixy="0" ixz="-0.0000001" iyy="0.0000254" iyz="0.0000036" izz="0.000021" />
    </inertial>
  </link>
  <link name="left_arm_fixed_jaw">
    <visual>
      <origin xyz="0.000000 0.000000 0.000000" rpy="0.000000 -0.000000 0.000000" />
      <geometry>
        <mesh filename="meshes/Fixed_Jaw.stl" />
      </geometry>
      <material name="left_arm_fixed_jaw_Fixed_Jaw.stl">
        <color rgba="0.85 0.85 0.85 1" />
      </material>
    </visual>
    <visual>
      <origin xyz="0.000000 0.000000 0.000000" rpy="0.000000 -0.000000 0.000000" />
      <geometry>
        <mesh filename="meshes/Fixed_Jaw_Motor.stl" />
      </geometry>
      <material name="left_arm_fixed_jaw_Fixed_Jaw_Motor.stl">
        <color rgba="0.1 0.1 0.1 1" />
      </material>
    </visual>
    <collision>
      <origin xyz="0.000000 0.000000 0.000000" rpy="0.000000 -0.000000 0.000000" />
      <geometry>
        <mesh filename="meshes/Fixed_Jaw_Motor.hull.stl" />
      </geometry>
    </collision>
    <collision>
      <origin xyz="0.000000 0.000000 0.000000" rpy="0.000000 -0.000000 0.000000" />
      <geometry>
        <mesh filename="meshes/Fixed_Jaw_part1.ply.convex.stl" />
      </geometry>
    </collision>
    <collision>
      <origin xyz="0.000000 0.000000 0.000000" rpy="0.000000 -0.000000 0.000000" />
      <geometry>
        <mesh filename="meshes/Fixed_Jaw_part2.ply.convex.stl" />
      </geometry>
    </collision>
    <inertial>
      <origin xyz="0.0002136 0.0002451 -0.025187" rpy="0 0 0" />
      <mass value="0.087" />
      <inertia ixx="0.0000275" ixy="-0.0000003" ixz="-0.0000057" iyy="0.0000434" iyz="-0.0000001" izz="0.0000345" />
    </inertial>
  </link>
  <link name="left_arm_moving_jaw">
    <visual>
      <origin xyz="0.000000 0.000000 0.000000" rpy="0.000000 -0.000000 0.000000" />
      <geometry>
        <mesh filename="meshes/Moving_Jaw.stl" />
      </geometry>
      <material name="left_arm_moving_jaw_Moving_Jaw.stl">
        <color rgba="0.85 0.85 0.85 1" />
      </material>
    </visual>
    <collision>
      <origin xyz="0.000000 0.000000 0.000000" rpy="0.000000 -0.000000 0.000000" />
      <geometry>
        <mesh filename="meshes/Moving_Jaw_part1.ply.convex.stl" />
      </geometry>
    </collision>
    <collision>
      <origin xyz="0.000000 0.000000 0.000000" rpy="0.000000 -0.000000 0.000000" />
      <geometry>
        <mesh filename="meshes/Moving_Jaw_part2.ply.convex.stl" />
      </geometry>
    </collision>
    <collision>
      <origin xyz="0.000000 0.000000 0.000000" rpy="0.000000 -0.000000 0.000000" />
      <geometry>
        <mesh filename="meshes/Moving_Jaw_part3.ply.convex.stl" />
      </geometry>
    </collision>
    <inertial>
      <origin xyz="-0.001575 -0.0300244 0.0192755" rpy="0 0 0" />
      <mass value="0.012" />
      <inertia ixx="0.0000066" ixy="-0.0000003" ixz="0" iyy="0.0000019" iyz="-0.0000001" izz="0.0000053" />
    </inertial>
  </link>
  <joint name="left_arm_mount" type="fixed">
    <parent link="wallerobot_body" />
    <child link="left_arm_base" />
    <origin xyz="-0.067100 -0.132900 0.048000" rpy="0.000000 -0.000000 -1.570796" />
  </joint>
  <joint name="left_arm_shoulder_pan" type="revolute">
    <parent link="left_arm_base" />
    <child link="left_arm_shoulder" />
    <origin xyz="0.000000 -0.045200 0.016500" rpy="1.570800 -0.000000 0.000000" />
    <axis xyz="0 -1 0" />
    <limit lower="-1.8699" upper="0.8145" effort="3.35" velocity="3" />
  </joint>
  <joint name="left_arm_shoulder_lift" type="revolute">
    <parent link="left_arm_shoulder" />
    <child link="left_arm_upper_arm" />
    <origin xyz="0.000000 0.102500 0.030600" rpy="1.570800 -0.000000 0.000000" />
    <axis xyz="-1 0 0" />
    <limit lower="-0.2200" upper="3.3700" effort="3.35" velocity="3" />
  </joint>
  <joint name="left_arm_elbow_flex" type="revolute">
    <parent link="left_arm_upper_arm" />
    <child link="left_arm_lower_arm" />
    <origin xyz="0.000000 0.112570 0.028000" rpy="-1.570800 -0.000000 0.000000" />
    <axis xyz="1 0 0" />
    <limit lower="-0.2200" upper="3.1400" effort="3.35" velocity="3" />
  </joint>
  <joint name="left_arm_wrist_flex" type="revolute">
    <parent link="left_arm_lower_arm" />
    <child link="left_arm_wrist" />
    <origin xyz="0.000000 0.005200 0.134900" rpy="-1.570800 -0.000000 0.000000" />
    <axis xyz="1 0 0" />
    <limit lower="-1.4711" upper="1.6581" effort="3.35" velocity="3" />
  </joint>
  <joint name="left_arm_wrist_roll" type="revolute">
    <parent link="left_arm_wrist" />
    <child link="left_arm_fixed_jaw" />
    <origin xyz="0.000000 -0.060100 0.000000" rpy="0.000000 1.570793 0.000000" />
    <axis xyz="0 -1 0" />
    <limit lower="-1.4067" upper="2.8412" effort="3.35" velocity="3" />
  </joint>
  <joint name="left_arm_gripper" type="revolute">
    <parent link="left_arm_fixed_jaw" />
    <child link="left_arm_moving_jaw" />
    <origin xyz="-0.020200 -0.024400 0.000000" rpy="3.141585 -0.000001 2.953185" />
    <axis xyz="0 0 1" />
    <limit lower="-0.3840" upper="1.7453" effort="3.35" velocity="3" />
  </joint>
  <link name="left_wrist_camera">
    <visual>
      <origin xyz="-0.015000 -0.026000 0.000000" rpy="0.000000 -0.000000 0.000000" />
      <geometry>
        <mesh filename="meshes/XLeRobot_camera1.stl" scale="0.001 0.001 0.001" />
      </geometry>
      <material name="left_wrist_camera_XLeRobot_camera1.stl">
        <color rgba="0.1 0.1 0.1 1" />
      </material>
    </visual>
    <visual>
      <origin xyz="-0.015000 -0.026000 0.000000" rpy="0.000000 -0.000000 0.000000" />
      <geometry>
        <mesh filename="meshes/XLeRobot_camera2.stl" scale="0.001 0.001 0.001" />
      </geometry>
      <material name="left_wrist_camera_XLeRobot_camera2.stl">
        <color rgba="0.1 0.1 0.1 1" />
      </material>
    </visual>
  </link>
  <joint name="left_wrist_camera_joint" type="fixed">
    <parent link="left_arm_fixed_jaw" />
    <child link="left_wrist_camera" />
    <origin xyz="0.000000 -0.022000 0.050000" rpy="1.570796 0.000004 -1.570800" />
  </joint>
  <link name="left_arm_fixed_jaw_tip" />
  <joint name="left_arm_fixed_jaw_tip_joint" type="fixed">
    <parent link="left_arm_fixed_jaw" />
    <child link="left_arm_fixed_jaw_tip" />
    <origin xyz="0.010000 -0.097000 0.000000" rpy="0.000000 -0.000000 0.000000" />
  </joint>
  <link name="left_arm_moving_jaw_tip" />
  <joint name="left_arm_moving_jaw_tip_joint" type="fixed">
    <parent link="left_arm_moving_jaw" />
    <child link="left_arm_moving_jaw_tip" />
    <origin xyz="-0.010000 -0.073000 0.000000" rpy="0.000000 -0.000000 0.000000" />
  </joint>
  <link name="right_arm_base">
    <visual>
      <origin xyz="0.000000 0.000000 0.000000" rpy="0.000000 -0.000000 0.000000" />
      <geometry>
        <mesh filename="meshes/Base.stl" />
      </geometry>
      <material name="right_arm_base_Base.stl">
        <color rgba="0.35 0.35 0.38 1" />
      </material>
    </visual>
    <visual>
      <origin xyz="0.000000 0.000000 0.000000" rpy="0.000000 -0.000000 0.000000" />
      <geometry>
        <mesh filename="meshes/Base_Motor.stl" />
      </geometry>
      <material name="right_arm_base_Base_Motor.stl">
        <color rgba="0.1 0.1 0.1 1" />
      </material>
    </visual>
    <collision>
      <origin xyz="0.000000 0.000000 0.000000" rpy="0.000000 -0.000000 0.000000" />
      <geometry>
        <mesh filename="meshes/Base_Motor.hull.stl" />
      </geometry>
    </collision>
    <collision>
      <origin xyz="0.000000 0.000000 0.000000" rpy="0.000000 -0.000000 0.000000" />
      <geometry>
        <mesh filename="meshes/Base.hull.stl" />
      </geometry>
    </collision>
    <inertial>
      <origin xyz="0.0137179 -0.000052 0.0334843" rpy="0 0 0" />
      <mass value="0.147" />
      <inertia ixx="0.0001147" ixy="-0.0000005" ixz="0.000005" iyy="0.0001361" iyz="0.0000001" izz="0.0001304" />
    </inertial>
  </link>
  <link name="right_arm_shoulder">
    <visual>
      <origin xyz="0.000000 0.000000 0.000000" rpy="0.000000 -0.000000 0.000000" />
      <geometry>
        <mesh filename="meshes/Rotation_Pitch.stl" />
      </geometry>
      <material name="right_arm_shoulder_Rotation_Pitch.stl">
        <color rgba="0.35 0.35 0.38 1" />
      </material>
    </visual>
    <visual>
      <origin xyz="0.000000 0.000000 0.000000" rpy="0.000000 -0.000000 0.000000" />
      <geometry>
        <mesh filename="meshes/Rotation_Pitch_Motor.stl" />
      </geometry>
      <material name="right_arm_shoulder_Rotation_Pitch_Motor.stl">
        <color rgba="0.1 0.1 0.1 1" />
      </material>
    </visual>
    <collision>
      <origin xyz="0.000000 0.000000 0.000000" rpy="0.000000 -0.000000 0.000000" />
      <geometry>
        <mesh filename="meshes/Rotation_Pitch_Motor.hull.stl" />
      </geometry>
    </collision>
    <collision>
      <origin xyz="0.000000 0.000000 0.000000" rpy="0.000000 -0.000000 0.000000" />
      <geometry>
        <mesh filename="meshes/Rotation_Pitch.hull.stl" />
      </geometry>
    </collision>
    <inertial>
      <origin xyz="-0.0307604 -0.0000167 -0.0252713" rpy="0 0 0" />
      <mass value="0.100006" />
      <inertia ixx="0.0000838" ixy="0.0000001" ixz="-0.0000012" iyy="0.000081" iyz="0.0000002" izz="0.000024" />
    </inertial>
  </link>
  <link name="right_arm_upper_arm">
    <visual>
      <origin xyz="0.000000 0.000000 0.000000" rpy="0.000000 -0.000000 0.000000" />
      <geometry>
        <mesh filename="meshes/Upper_Arm.stl" />
      </geometry>
      <material name="right_arm_upper_arm_Upper_Arm.stl">
        <color rgba="0.35 0.35 0.38 1" />
      </material>
    </visual>
    <visual>
      <origin xyz="0.000000 0.000000 0.000000" rpy="0.000000 -0.000000 0.000000" />
      <geometry>
        <mesh filename="meshes/Upper_Arm_Motor.stl" />
      </geometry>
      <material name="right_arm_upper_arm_Upper_Arm_Motor.stl">
        <color rgba="0.1 0.1 0.1 1" />
      </material>
    </visual>
    <collision>
      <origin xyz="0.000000 0.000000 0.000000" rpy="0.000000 -0.000000 0.000000" />
      <geometry>
        <mesh filename="meshes/Upper_Arm_Motor.hull.stl" />
      </geometry>
    </collision>
    <collision>
      <origin xyz="0.000000 0.000000 0.000000" rpy="0.000000 -0.000000 0.000000" />
      <geometry>
        <mesh filename="meshes/Upper_Arm.hull.stl" />
      </geometry>
    </collision>
    <inertial>
      <origin xyz="-0.0898471 -0.0083822 0.0184089" rpy="0 0 0" />
      <mass value="0.103" />
      <inertia ixx="0.0000408" ixy="-0.0000198" ixz="0" iyy="0.0001473" iyz="0" izz="0.0001425" />
    </inertial>
  </link>
  <link name="right_arm_lower_arm">
    <visual>
      <origin xyz="0.000000 0.000000 0.000000" rpy="0.000000 -0.000000 0.000000" />
      <geometry>
        <mesh filename="meshes/Lower_Arm.stl" />
      </geometry>
      <material name="right_arm_lower_arm_Lower_Arm.stl">
        <color rgba="0.35 0.35 0.38 1" />
      </material>
    </visual>
    <visual>
      <origin xyz="0.000000 0.000000 0.000000" rpy="0.000000 -0.000000 0.000000" />
      <geometry>
        <mesh filename="meshes/Lower_Arm_Motor.stl" />
      </geometry>
      <material name="right_arm_lower_arm_Lower_Arm_Motor.stl">
        <color rgba="0.1 0.1 0.1 1" />
      </material>
    </visual>
    <collision>
      <origin xyz="0.000000 0.000000 0.000000" rpy="0.000000 -0.000000 0.000000" />
      <geometry>
        <mesh filename="meshes/Lower_Arm_Motor.hull.stl" />
      </geometry>
    </collision>
    <collision>
      <origin xyz="0.000000 0.000000 0.000000" rpy="0.000000 -0.000000 0.000000" />
      <geometry>
        <mesh filename="meshes/Lower_Arm.hull.stl" />
      </geometry>
    </collision>
    <inertial>
      <origin xyz="-0.0980701 0.0032438 0.0182831" rpy="0 0 0" />
      <mass value="0.104" />
      <inertia ixx="0.0000287" ixy="0.0000074" ixz="0.0000013" iyy="0.0001598" iyz="0" izz="0.0001453" />
    </inertial>
  </link>
  <link name="right_arm_wrist">
    <visual>
      <origin xyz="0.000000 0.000000 0.000000" rpy="0.000000 -0.000000 0.000000" />
      <geometry>
        <mesh filename="meshes/Wrist_Pitch_Roll.stl" />
      </geometry>
      <material name="right_arm_wrist_Wrist_Pitch_Roll.stl">
        <color rgba="0.35 0.35 0.38 1" />
      </material>
    </visual>
    <visual>
      <origin xyz="0.000000 0.000000 0.000000" rpy="0.000000 -0.000000 0.000000" />
      <geometry>
        <mesh filename="meshes/Wrist_Pitch_Roll_Motor.stl" />
      </geometry>
      <material name="right_arm_wrist_Wrist_Pitch_Roll_Motor.stl">
        <color rgba="0.1 0.1 0.1 1" />
      </material>
    </visual>
    <collision>
      <origin xyz="0.000000 0.000000 0.000000" rpy="0.000000 -0.000000 0.000000" />
      <geometry>
        <mesh filename="meshes/Wrist_Pitch_Roll_Motor.hull.stl" />
      </geometry>
    </collision>
    <collision>
      <origin xyz="0.000000 0.000000 0.000000" rpy="0.000000 -0.000000 0.000000" />
      <geometry>
        <mesh filename="meshes/Wrist_Pitch_Roll.hull.stl" />
      </geometry>
    </collision>
    <inertial>
      <origin xyz="-0.0001033 -0.0386143 0.0281156" rpy="0 0 0" />
      <mass value="0.079" />
      <inertia ixx="0.0000368" ixy="0" ixz="-0.0000001" iyy="0.0000254" iyz="0.0000036" izz="0.000021" />
    </inertial>
  </link>
  <link name="right_arm_fixed_jaw">
    <visual>
      <origin xyz="0.000000 0.000000 0.000000" rpy="0.000000 -0.000000 0.000000" />
      <geometry>
        <mesh filename="meshes/Fixed_Jaw.stl" />
      </geometry>
      <material name="right_arm_fixed_jaw_Fixed_Jaw.stl">
        <color rgba="0.35 0.35 0.38 1" />
      </material>
    </visual>
    <visual>
      <origin xyz="0.000000 0.000000 0.000000" rpy="0.000000 -0.000000 0.000000" />
      <geometry>
        <mesh filename="meshes/Fixed_Jaw_Motor.stl" />
      </geometry>
      <material name="right_arm_fixed_jaw_Fixed_Jaw_Motor.stl">
        <color rgba="0.1 0.1 0.1 1" />
      </material>
    </visual>
    <collision>
      <origin xyz="0.000000 0.000000 0.000000" rpy="0.000000 -0.000000 0.000000" />
      <geometry>
        <mesh filename="meshes/Fixed_Jaw_Motor.hull.stl" />
      </geometry>
    </collision>
    <collision>
      <origin xyz="0.000000 0.000000 0.000000" rpy="0.000000 -0.000000 0.000000" />
      <geometry>
        <mesh filename="meshes/Fixed_Jaw_part1.ply.convex.stl" />
      </geometry>
    </collision>
    <collision>
      <origin xyz="0.000000 0.000000 0.000000" rpy="0.000000 -0.000000 0.000000" />
      <geometry>
        <mesh filename="meshes/Fixed_Jaw_part2.ply.convex.stl" />
      </geometry>
    </collision>
    <inertial>
      <origin xyz="0.0002136 0.0002451 -0.025187" rpy="0 0 0" />
      <mass value="0.087" />
      <inertia ixx="0.0000275" ixy="-0.0000003" ixz="-0.0000057" iyy="0.0000434" iyz="-0.0000001" izz="0.0000345" />
    </inertial>
  </link>
  <link name="right_arm_moving_jaw">
    <visual>
      <origin xyz="0.000000 0.000000 0.000000" rpy="0.000000 -0.000000 0.000000" />
      <geometry>
        <mesh filename="meshes/Moving_Jaw.stl" />
      </geometry>
      <material name="right_arm_moving_jaw_Moving_Jaw.stl">
        <color rgba="0.35 0.35 0.38 1" />
      </material>
    </visual>
    <collision>
      <origin xyz="0.000000 0.000000 0.000000" rpy="0.000000 -0.000000 0.000000" />
      <geometry>
        <mesh filename="meshes/Moving_Jaw_part1.ply.convex.stl" />
      </geometry>
    </collision>
    <collision>
      <origin xyz="0.000000 0.000000 0.000000" rpy="0.000000 -0.000000 0.000000" />
      <geometry>
        <mesh filename="meshes/Moving_Jaw_part2.ply.convex.stl" />
      </geometry>
    </collision>
    <collision>
      <origin xyz="0.000000 0.000000 0.000000" rpy="0.000000 -0.000000 0.000000" />
      <geometry>
        <mesh filename="meshes/Moving_Jaw_part3.ply.convex.stl" />
      </geometry>
    </collision>
    <inertial>
      <origin xyz="-0.001575 -0.0300244 0.0192755" rpy="0 0 0" />
      <mass value="0.012" />
      <inertia ixx="0.0000066" ixy="-0.0000003" ixz="0" iyy="0.0000019" iyz="-0.0000001" izz="0.0000053" />
    </inertial>
  </link>
  <joint name="right_arm_mount" type="fixed">
    <parent link="wallerobot_body" />
    <child link="right_arm_base" />
    <origin xyz="-0.067100 0.132900 0.048000" rpy="0.000000 -0.000000 -1.570796" />
  </joint>
  <joint name="right_arm_shoulder_pan" type="revolute">
    <parent link="right_arm_base" />
    <child link="right_arm_shoulder" />
    <origin xyz="0.000000 -0.045200 0.016500" rpy="1.570800 -0.000000 0.000000" />
    <axis xyz="0 -1 0" />
    <limit lower="-0.9020" upper="1.7687" effort="3.35" velocity="3" />
  </joint>
  <joint name="right_arm_shoulder_lift" type="revolute">
    <parent link="right_arm_shoulder" />
    <child link="right_arm_upper_arm" />
    <origin xyz="0.000000 0.102500 0.030600" rpy="1.570800 -0.000000 0.000000" />
    <axis xyz="-1 0 0" />
    <limit lower="-0.2200" upper="3.3700" effort="3.35" velocity="3" />
  </joint>
  <joint name="right_arm_elbow_flex" type="revolute">
    <parent link="right_arm_upper_arm" />
    <child link="right_arm_lower_arm" />
    <origin xyz="0.000000 0.112570 0.028000" rpy="-1.570800 -0.000000 0.000000" />
    <axis xyz="1 0 0" />
    <limit lower="-0.2200" upper="3.1400" effort="3.35" velocity="3" />
  </joint>
  <joint name="right_arm_wrist_flex" type="revolute">
    <parent link="right_arm_lower_arm" />
    <child link="right_arm_wrist" />
    <origin xyz="0.000000 0.005200 0.134900" rpy="-1.570800 -0.000000 0.000000" />
    <axis xyz="1 0 0" />
    <limit lower="-1.3591" upper="1.2487" effort="3.35" velocity="3" />
  </joint>
  <joint name="right_arm_wrist_roll" type="revolute">
    <parent link="right_arm_wrist" />
    <child link="right_arm_fixed_jaw" />
    <origin xyz="0.000000 -0.060100 0.000000" rpy="0.000000 1.570793 0.000000" />
    <axis xyz="0 -1 0" />
    <limit lower="-2.7438" upper="2.4774" effort="3.35" velocity="3" />
  </joint>
  <joint name="right_arm_gripper" type="revolute">
    <parent link="right_arm_fixed_jaw" />
    <child link="right_arm_moving_jaw" />
    <origin xyz="-0.020200 -0.024400 0.000000" rpy="3.141585 -0.000001 2.953185" />
    <axis xyz="0 0 1" />
    <limit lower="-0.3840" upper="1.7453" effort="3.35" velocity="3" />
  </joint>
  <link name="right_wrist_camera">
    <visual>
      <origin xyz="-0.015000 -0.026000 0.000000" rpy="0.000000 -0.000000 0.000000" />
      <geometry>
        <mesh filename="meshes/XLeRobot_camera1.stl" scale="0.001 0.001 0.001" />
      </geometry>
      <material name="right_wrist_camera_XLeRobot_camera1.stl">
        <color rgba="0.1 0.1 0.1 1" />
      </material>
    </visual>
    <visual>
      <origin xyz="-0.015000 -0.026000 0.000000" rpy="0.000000 -0.000000 0.000000" />
      <geometry>
        <mesh filename="meshes/XLeRobot_camera2.stl" scale="0.001 0.001 0.001" />
      </geometry>
      <material name="right_wrist_camera_XLeRobot_camera2.stl">
        <color rgba="0.1 0.1 0.1 1" />
      </material>
    </visual>
  </link>
  <joint name="right_wrist_camera_joint" type="fixed">
    <parent link="right_arm_fixed_jaw" />
    <child link="right_wrist_camera" />
    <origin xyz="0.000000 -0.021000 0.050000" rpy="1.570796 0.000004 -1.570800" />
  </joint>
  <link name="right_arm_fixed_jaw_tip" />
  <joint name="right_arm_fixed_jaw_tip_joint" type="fixed">
    <parent link="right_arm_fixed_jaw" />
    <child link="right_arm_fixed_jaw_tip" />
    <origin xyz="0.010000 -0.097000 0.000000" rpy="0.000000 -0.000000 0.000000" />
  </joint>
  <link name="right_arm_moving_jaw_tip" />
  <joint name="right_arm_moving_jaw_tip_joint" type="fixed">
    <parent link="right_arm_moving_jaw" />
    <child link="right_arm_moving_jaw_tip" />
    <origin xyz="-0.010000 -0.073000 0.000000" rpy="0.000000 -0.000000 0.000000" />
  </joint>
</robot>
