lauyihong/lerobotneck/(commit log)

2026-11-08 wallerobot v0.1: configurable model, bilingual docs, web simulator
    - hardware/: robot.yaml-driven URDF/MJCF build (hardware/build_all.py,
    --check, variants), vendored XLeRobot URDF + meshes (Apache-2.0)
    - docs_site/: Sphinx + MyST docs, English with a Chinese mirror
    - projects/web_sim/: MuJoCo WASM + three.js browser simulator
    - projects/sim_mirror/: MJCF model, viewer, read-only real/sim mirror
    - plugins/: LeRobot robot plugin (xlerobot_static)
    - CI: model consistency check, web build, docs build, Pages deploy
    [Base.hull.stl, Base.stl, Base_Motor.hull.stl, Base_Motor.stl, Fixed_Jaw.stl, Fixed_Jaw_Motor.hull.stl, Fixed_Jaw_Motor.stl, Fixed_Jaw_part1.ply.convex.stl]
2026-11-09 LeRobotNeck showcase website; docs move to /docs/
    - New neck-only model variant (hardware/variants/lerobotneck.yaml), built by build_all.py and exported to web/public/model_neck
    - Website at /: LeRobotNeck home demo, play/ neck simulator (pause, adjust joints, resume), neck/ exploded view (standard SO101 + 2 new prints)
    - Full wallerobot simulator stays at /sim/
    - Docs are now served at /docs/ (Chinese at /docs/zh/)
    [Fixed_Jaw.stl, Fixed_Jaw_Motor.stl, Lower_Arm.stl, Lower_Arm_Motor.stl, Moving_Jaw.stl, Rotation_Pitch.stl, Rotation_Pitch_Motor.stl, Upper_Arm.stl]
2026-11-09 LeRobotNeck: compact phone layout, two active-perception demos
    - Phone simulator: compact bottom sheet (demo strip + transport, joints behind a toggle), one-line nav, D435i inset top left
    - New demos: circle the green block, look inside the box (viewpoints solved with IK, visibility checked with ray tests)
    - Desk objects described in web/public/routes_neck/scene.json
2026-11-09 Correct the part attribution: the J6 housing is XLeRobot's soft-gripper jaw
    - Only the J3-J4 link is a new design; the J6 housing is XLeRobot's soft-gripper fixed jaw (holder of its TPU fin-ray finger), already there on an SO101 with that swappable gripper head
    - Exploded view, home page, page descriptions, BOM and READMEs updated
2026-11-10 Add the active perception page (/why/): six camera setups compared
    Same desk scene, same D435i camera model, six ways to hold it: fixed camera,
    XLeRobot 2-axis head, stock SO101 + wrist camera, SO101-X (the camera holder
    on the stock gripper, no new parts), LeRobotNeck and the LeRobotNeck-02
    concept (J3-J4 link as long as the stock lower arm). Coloured point clouds
    show what each can see, with its 10 best views, 80 requested-view tasks and
    how much of the image the robot itself covers. Data precomputed by
    projects/web_sim/scripts/make_coverage.py (simulation only).
    [tophead4.stl, tophead5.stl, tophead6.stl]
2026-11-10 Homepage: the camera stat says "D435i or any other camera supported by SO101"
